mettinoktay/Final_Thesis/README.md

# Final_Thesis

Is anyone reading this? Okay.

Here is the bachelor thesis work of mine at Yıldız Technical University in İstanbul. I'm building a small scale wind turbine.
