mettinoktay/Final_Thesis/Final Report/#3 Teşekkür.docx

Teşekkür

Tezim süresince yardımlarını esirgemeyen danışmanım Yrd. Doç. Dr. Hatice Mercan’a,

parçaları üretmemde cömertçe yardımda bulunan PrintekLabs’ın kurucuları Samet ve Onur’a,

ve özellikle aileme

ne kadar teşekkür etsem az kalır.
