mettinoktay/Final_Thesis/Final Report/#1 Kapak.docx

YILDIZ TEKNİK ÜNİVERSİTESİ

MAKİNE MÜHENDİSLİĞİ FAKÜLTESİ

YATAY EKSEN RÜZGAR TÜRBİNİ

ÜRETİMİ ve TEST EDİLMESİ

Metin Oktay Yılmaz

11067027

MEKATRONİK MÜHENDİSLİĞİ ANABİLİM DALI’NDA HAZIRLANAN

BİTİRME TEZİ

Tez Danışmanı: Yrd. Doç. Dr. Hatice Mercan

İstanbul, 2016
