mettinoktay/Final_Thesis/Design Report - Turkish/MST Raporu - 2015 Güz - Metin Oktay Yılmaz - 11067027.pdf

### YILDIZ TEKNİK ÜNİVERSİTESİ MAKİNE MÜHENDİSLİĞİ FAKÜLTESİ

## YATAY EKSEN RÜZGAR TÜRBİNİ TASARIMI ve KONTROLÜ

### Metin Oktay Yılmaz

11067027

MEKATRONİK MÜHENDİSLİĞİ ANABİLİM DALI’NDA HAZIRLANAN

## MEKATRONİK SİSTEM TASARIMI RAPORU

### Proje Danışmanı: Yrd. Doç. Dr. Hatice Mercan

İstanbul, 2015

### YILDIZ TEKNİK ÜNİVERSİTESİ

### MAKİNE MÜHENDİSLİĞİ FAKÜLTESİ

## YATAY EKSEN RÜZGAR TÜRBİNİ

## TASARIMI ve KONTROLÜ

### Metin Oktay Yılmaz

11067027

MEKATRONİK MÜHENDİSLİĞİ ANABİLİM DALI’NDA HAZIRLANAN

## MEKATRONİK SİSTEM TASARIMI RAPORU

### Proje Danışmanı: Yrd. Doç. Dr. Hatice Mercan

İstanbul, 2015

İçindekiler

### 5.5 Dönel Akışın İhmal Edildiği Şartlarda İdeal Kanat Geometrisi ve Kanat Elemanı

REVİZYON TARİHÇESİ

Tarih | Rev. Numarası | Tanım | Yazar(lar)
25.12.2015 | 1.0 | Başlangıç Dokümanı | Metin Oktay Yılmaz

SİMGE LİSTESİ

c: Kanat veter uzunluğu, sönümleme katsayısı

m: Kütle

k: Yay sabiti

r: Rotor merkezine olan uzaklık, yarıçap

dr: Elemanın uzunluğu

R: Rotor yarıçapı

m: Kütle

k: Yay sabiti

V, U: Hız

P: Güç

F: Kuvvet

Q: Tork

a1..n : Regresyon katsayıları

a: İndüksiyon faktörü

k: Şekil parametresi

c: Ölçek parametresi

Cp: Kapasite faktörü

Ke: Enerji patern faktörü

CL: Taşıma katsayısı

CD: Sürükleme katsayısı

B: Kanat sayısı

P, I, D: PID denetleyici katsayıları

L: Laplace dönüşümü

YUNAN HARFLERİ

Ω: Rotor açısal hızı

α: Hücum açısı

ρ: Yoğunluk

Ω: Rotor açısal hızı

φ: Bağıl rüzgar hızı açısı

λ: Uç hız oranı

σ: Standart sapma

θx: Kanat ile ilişkili açılar

Δ: Diskriminant

KISALTMALAR
TÜREB Türkiye Rüzgar Enerjisi Birliği

GWEC Global Wind Energy Council

IEA International Energy Association

EWEA European Wind Energy Association

ŞEKİL LİSTESİ

ŞEKIL 1: KITALARA GÖRE YILLIK TÜRBIN KURULUM MIKTARI [10] | 8
ŞEKIL 2: TÜRKIYE’DE YILLARA GÖRE TÜRBIN KURULUMU [1]. İZINSIZ KULLANILMIŞTIR | 9
ŞEKIL 3: YATAY EKSEN VE DIKEY EKSEN RÜZGAR TÜRBINI | 9
ŞEKIL 4: VESTAS V47-660 KW TÜRBININE AIT GÜÇ EĞRISI | 11
ŞEKIL 5: YILLIK RÜZGAR HIZI DATASI VE WEIBULL DAĞILIMI | 14
ŞEKIL 6: RÜZGAR TÜRBINI EYLEYICI DISK MODELI | 14
ŞEKIL 7: BETZ TÜRBINI IÇIN ÇALIŞMA PARAMETRELERI | 18
ŞEKIL 8: DÖNEL AKIŞLI EYLEYICI DISK MODELI | 18
ŞEKIL 9: ROTOR ANALIZINDE KULLANACAĞIMIZ GEOMETRI | 18
ŞEKIL 10: NACA5518 PROFILI VE XFOİL’DE ÇIKARILMIŞ CL/CD GRAFIĞI | 22
ŞEKIL 11: KANAT ELEMAN TEORISINDE KULLANILACAK KANAT MODELI | 24
ŞEKIL 12: ANALIZDE KULLANILACAK KANAT GEOMETRISI VE NOTASYONLAR | 24
ŞEKIL 13: VETER UZUNLUĞU VE BURULMA AÇISI KANAT BOYU DAĞILIMLARI | 28
ŞEKIL 14: YARIÇAPI 1 METRE OLAN TÜRBININ VETER UZUNLUĞU DAĞILIMI | 29
ŞEKIL 15: DÖNEL AKIŞLI TÜRBININ VETER VE BURULMA DAĞILIMI | 30
ŞEKIL 16: t = 0’DAN SONRA SİSTEME UYGULANMIŞ BASAMAK FONKSIYONU | 31
ŞEKIL 17: DÜŞÜK SÖNÜMLÜ SISTEMIN BASAMAK CEVABI | 32
ŞEKIL 18: KARARLI SÖNÜMLÜ SISTEMIN BASAMAK CEVABI | 32
ŞEKIL 19: AŞIRI SÖNÜMLÜ SISTEMIN BASAMAK CEVABI | 33
ŞEKIL 20: DÜŞÜK SÖNÜMLÜ SISTEMIN FARKLI P KATSAYILARINA TEPKISI | 33
ŞEKIL 21: P KATSAYISININ KARARLI SÖNÜMLÜ SISTEM ÜZERINE ETKISI | 34
ŞEKIL 22: P KATSAYISININ AŞIRI SÖNÜMLÜ SISTEM ÜZERINE ETKISI | 34
ŞEKIL 23: I KATSAYISININ DÜŞÜK SÖNÜMLÜ SISTEM ÜZERINE ETKISI | 34
ŞEKIL 24: I KATSAYISININ KARARLI SÖNÜMLÜ SISTEM ÜZERINE ETKISI | 35
ŞEKIL 25: I KATSAYISININ AŞIRI SÖNÜMLÜ SISTEM ÜZERINE ETKISI | 35
ŞEKIL 26: D KATSAYISININ DÜŞÜK SÖNÜMLÜ SISTEM ÜZERINE ETKISI | 35
ŞEKIL 27: D KATSAYISININ KARARLI SÖNÜMLÜ SISTEM ÜZERINE ETKISI | 36
ŞEKIL 28: D KATSAYISININ AŞIRI SÖNÜMLÜ SISTEM ÜZERINE ETKISI | 36
ŞEKIL 29: VETER UZUNLUĞU DAĞILIMI GRAFIĞI | 37
ŞEKIL 30: BURULMA AÇISI DAĞILIMI GRAFIĞI | 37
ŞEKIL 31: ELDE EDILEN VERILERLE OLUŞTULAN ROTOR | 37
ŞEKIL 32: QBLADE'IN OPTIMIZAYONU SONUCU ELDE EDILEN ROTOR | 37
ŞEKIL 33: SEEEDUINO ARCH PRO | 38
ŞEKIL 34: SISTEMIN KABA BLOK DIYAGRAMI | 39
ŞEKIL 35: KART ŞEMATIĞI | 41
ŞEKIL 36: PROJE TAKVIMI | 44

TABLO LİSTESİ

TABLO 1: λ VE a2 FONKSIYONU OLARAK Cp, max | 22

FOTOĞRAF LİSTESİ

FOTOĞRAF 1: KAFEE MUEHLE, BREMEN, ALMANYA [5] | 7

ÖZET

Bu çalışmada, yatay eksen rüzgar türbinleri incelenmiş ve 50W güç üretecek bir türbin

tasarlanmıştır. Fosil yakıtların zararlarının iyice görülmeye başlandığı bu yıllarda, yenilenebilir

enerji kaynaklarına olan rağbet artmıştır. Her geçen yıl daha fazla yatırım almakta olan rüzgar

enerjisi ülkemizde de aynı ilgiyi görmektedir.

İlk üç bölümde teorik bilgi verilmiş, son bölümde tasarım anlatılmıştır. Türbin kanatları, türbin

kontrol kartı ve kontrol algoritması tasarlanmıştır. Türbin tasarımı ve ilişkili analizler QBlade

ve MATLAB kullanılarak yapılmıştır. Proje dosyaları (ilerleyen zamanlarda kontrol yazılımı

da dahil) github.com/mettinoktay adresinden indirilebilir.

Anahtar kelimeler: rüzgar türbini, PID kontrol, türbin kontrolü, türbin tasarımı

### 1. GİRİŞ

### 1.1 Amaç

Bu projede amaç, 50 watt güç üretecek, 1 metre yarıçaplı bir türbin tasarlamak; elektronik devre

tasarımlarını yapmak ve kontrol algoritması geliştirmektir.

### 1.2 Motivasyon

Rüzgar türbini yatırımları her sene artmaktadır [1]. Ancak ülkemizde rüzgar türbinleri üzerine

Ar-Ge çalışmaları yürütülmemektedir. Bu naçizane çalışmanın, kendi hedeflerim için bir

başlangıç noktası olmasını hedeflemekteyim.

### 1.3 Kapsam

Bu proje, Yıldız Teknik Üniversitesi Mekatronik Mühendisliği bölümünde yapılmıştır.

Dolayısıyla tüm elektronik, mekanik ve yazılım işleri proje dahilindedir, ancak üretilmesi

planlanan türbinin boyutları derin analiz gerektirmemektedir. Bu sebeple matematiksel teori

basitleştirilmiştir.

### 1.4 Literatür Taraması

Çalışmanın teorik kısmı Wind Energy Explained Theory, Design and Application (ISBN 0

471 49972 2) kitabından ve [2] ve [3] makalelerinden alınmıştır. Türbin karakteristik eğrileri

veya değerleri literatürdeki makalelerden alınmıştır. Hava kirliliği konusundaki haberler

tr.euronews.com sitesinden alınmıştır. Rüzgar türbin yatırım trendleri ve son durumu hakkında

araştırma ulusal ve uluslararası kuruluşların raporlarından alınmıştır.

### 1.5 Kabuller ve Varsayımlar

Teorik ve Pratik kısımlarda yapılmış varsayımlar bölümlerde verilmiştir.

### 2. GEREKSİNİM SPESİFİKASYONLARI

### 2.1 Pazar Gereksinimleri

1. Verim %30’un üzerinde olmalıdır.
2. Dışarıdan bakıldığında estetik bir görüntü vermelidir.

Pazar Gereksinimleri | Teknik Gereksinimler | Açıklama
1 | Kanat tasarımı, ideal tasarıma yakın olmalıdır. | [4] incelenerek kararlaştırılmıştır.
2 | En az üç kanatlı bir rotor tasarlanmalıdır. | Kaynaklar incelenerek kararlaştırılmıştır.

### 3. RÜZGAR ENERJİSİ ve RÜZGAR TÜRBİNLERİ

Antik çağlardan bu yana enerjisinden faydalanılan rüzgar, genellikle değirmenlerde mısır ve

buğday öğütmek veya evlere su pompalamak için kullanımıştır. Günümüzde yerlerini elektrik

enerjisiyle çalışan tiplerine bırakan bu değirmenler, kimi yerlerde turistleri cezbetmek amacıyla

kullanılmaktadır.


Fotoğraf 1: Kafee Muehle, Bremen, Almanya [5]

Rüzgardan elektrik üretmenin llk denemeleri 1888 yılında Charles Brush tarafından Cleveland,

Ohio’da yapılmıştır [6]. Ardından geliştirme çalışmaları devam etmiş ancak 1900’lerin başında

fosil yakıtla çalışan enerji üreteçlerinin ortaya çıkması rüzgar enerjisini arka plana atmıştır. O

günden beri fosil yakıtlarla çalışan motorlar ve jeneratörler ilk tercih olmuştur ancak fosil

yakıtın zararlı getirileri, günümüzde etkisini hissettirmektedir. Dünya genelinde kimi şehirlerde

hava kirliliği tarihin en yüksek değerlerine ulaşmış, belediyeler önlemler almaya başlamışlardır

[7] [8]. Bu gibi sebepler, toplumu ve yöneticileri yenilenebilir enerji kaynaklarına

yaklaştırmıştır. Bu kaynaklar arasında en çok rağbet görenler güneş enerjisi, jeotermal enerji,

hidroelektrik enerji ve rüzgar enerjisidir.

### 3.1 Dünyada Rüzgar Enerjisi

Dünyada rüzgar enerjisinin gelişiminde öncü ülkeler Almanya, İspanya, Danimarka ve ABD

olmuştur. Danimarka, 2014 yılında enerji ihtiyacının %39.1’ini rüzgardan karşılamıştır [9].

Avrupa Birliği üye ülkeleri, 2030 yılında enerjisini %19’u ila %31’i arasında oranla rüzgardan

karşılamayı planlamaktadır.


Şekil 1: Kıtalara göre yıllık türbin kurulum miktarı [10]

### 3.2 Türkiye’de Durum

Türkiye, 2000 yılından bu yana her yıl artan oranda rüzgar enerjisine yatırım yapmaktadır

(Grafik 2). Türkiye Rüzgar Enerjisi Birliği’nin Ocak 2015 tarihli raporuna göre kurulumu

devam eden türbinlerin toplam gücü 1210 MW’tır [1]. Türkiye 2023 yılına kadar kurulu gücünü

9418 MW’a çıkarmayı planlamaktadır [11].

### 3.3 Modern Rüzgar Türbinleri

Rüzgar türbinleri, rotorlarının dönüş eksenine göre ikiye ayrılır: dikey eksen rüzgar türbinleri

ve yatay eksen rüzgar türbinleri. Dikey eksen rüzgar türbinleri, kurulumu ve işletimi kolay

ancak bakımı zor, verimi düşük makinelerdir. Yatay eksen rüzgar türbinleri ise kurulumu zor,

verimi yüksek ve bakımı kolay makinelerdir. Uzun vadede getirisi dikey eksen türbinlere oranla

daha yüksektir.

### 3.4 Yatay Eksen Rüzgar Türbini

Dikey eksen türbinlerden üstünlüklerini kanıtlayan yatay eksen türbinler üretici şirketlerin

tercihi olmuştur. Birkaç kişisel kullanım için kurulu dikey eksen türbinlerin dışında kurulu

türbinlerin tamamı yatay eksen türbinlerdir.


Şekil 2: Türkiye’de yıllara göre türbin kurulumu [1]. İzinsiz kullanılmıştır.


Şekil 3: Yatay eksen ve dikey eksen rüzgar türbini

Türbin Bileşenleri

Rotor

Rüzgarın mekanik enerjisini yakalayan parçadır. Kanat ve kanat merkezinden oluşur. Tek

kanatlı, iki kanatlı ve üç kanatlı olabilir. Küçük türbinlerde (10 kW ve altı) dört veya beş kanatlı

modeler görülebilir. Küçük türbinlerde sabit pitch açılı kanatlar kullanılırken büyük türbinlerde

aktif kontrollü tasarımlar tercih edilmektedir. Kanat geometrisinde dikkat edilmesi gereken

hususlar 3. bölümde anlatılacaktır.

Aktarma Organı

Rotor, yakaladığı enerjiyi aktarma organlarıyla jeneratöre aktarır. Aktarma organı genellikle

redüktör dişli sisteminden oluşur. Rotor jeneratörün elektrik üretemeyeceği açısal hızlarda dönmektedir. Bu sebeple rotor ile jeneratör bir redüktör dişli sistemi ile bağlanır ve rotor devri

yükseltgenerek jeneratöre aktarılır.

Jeneratör

Elektriğin üretildiği kısımdır. Jeneratörler alternative akım kaynağıdır. Çoğunlukla indüksiyon

jeneratörü veya senkron jeneratörler kullanılır. Şebeke frekansından farklı frekanslarda üretilen

AC gerilim, 60 Hz frekansa çekildikten sonra şebekeye aktarılır.

Beşik ve Yaw Sistemi

Beşik jeneratör, yaw sistemi, aktarma organı ve kontrolör için saklama kabı görevi görür.

Ayrıca üst aksamın yaw sistemi ile kuleye bağlanmasını da sağlar.

Yaw sistemi, rotorun, kule ekseni etrafında dönmesini ve rotorun rüzgarı karşıdan almasını

sağlar. Küçük türbinlerde, türbin arkasındanki yatay stabilizörler bu işi görürken, büyük

türbinlerde kütleden ötürü aktif kontrol gerekmektedir.

Kule ve Zemin

Türbin en nihayetinde kuleye oturtulur. Rüzgar hızı irtifa ile doğru orantılıdır. Kule uzunluğu,

bu ilişki göz önünde bulundurulara seçilir. Kule uzunluğu, coğrafi şartlara göre belirlenecek

minimum uzunluktan kısa kalmamak şartıyla en az rotor çapının 1-1.5 katı uzunluğunda

olmalıdır.

Kontrol Sistemi

Türbin verimi ve işletim kolaylığı açısından kontrol sistemi önemli role sahiptir. Rüzgar

şartlarına göre türbini manipüle edip aşırı yüklemeyi önlemek ve rüzgardan maksimum enerjiyi

çıkarmaya çalışmak kontrol sisteminin görevidir. Kontrol sistemi aşağıdaki elemanlardan

oluşur:

- Sensörler (sıcaklık, rüzgar hızı, rüzgar yönü ve sair)
- Eyleyiciler (yaw ve pitch motorları)
- Güç yükselteçleri (sürücü devreler)
- Denetleyici

### 3.5 Türbin Güç Eğrisi

Türbin güç eğrileri, türbinden farklı rüzgar hızlarında ne kadar güç alınabileceğini gösterirler.

Türbin eğrileri aşağıdaki parçalı fonksiyon kullanılarak hesaplanır:

f(x) = {

0 | , V < VI
(a1V

3 + a2V

| 2 + a3V + a4)PR , VI ≤ V < VR
PR | , VR ≤ V < VO
0 | , V ≥ VO

(0.1)

a1−4, türbin güç eğrisi regresyon katsayıları, PR, türbinin verebileceği maksimum enerji, V ise

rüzgar hızıdır. VI

türbinin dönmeye başladığı hız, VO ise türbinin yapısal olarak çalışmaya

dayanabileceği maksimum rüzgar hızıdır. Türbin VR − VO arasında maksimum verimle çalıştığı

hız aralığıdır.

Vestas V47-660kW türbini için regresyon katsayıları, VI

, VO, VR , PR [12] ve güç eğrisi

aşağıdaki gibidir:

a1 = −0.00169, | a2 = 0.04446, | a3 = −0.24764, | a4 = 0.39209
PR = 660kW, | VI = 4
| m s
| , | VO = 25m s
| | , | VR = 15 m s


Şekil 4: Vestas v47-660 kW türbinine ait güç eğrisi

### 4. RÜZGAR ANALİZİ

Her rüzgar estiği düşünülen alan, türbin kurulumu için uygun değildir. Sürekli enerji elde

etmeye elverişli olduğu düşünülen bir alanda, uzun zaman boyunca ölçüm yapılır. Elde edilen

veriler, çeşitli yöntemlerle anlamlandırılır. Türbin verileri ve alan verileri bir arada

kullanıldığında bir alandan elde edilebilecek enerji miktarı kestirilebilir. Sonuç olarak, alanın

ekonomik değerinin olup olmadığı kararlaştırılmış olur.

Rüzgar hızı ölçerken, her saniye rüzgar hızını ölçmek etkili bir yöntem olarak görülmemektedir.

IEA’nın tavsiyesi, rüzgar hızını 10 dakikada bir ölçmek ve ölçülen her gün için ayrı ayrı rüzgar

hızı ortalamalarını almaktır [12].

Türkiye, rüzgardan enerji elde etme potansiyeli yüksek bir ülkedir. Enerji potansiyeli en yüksek

bölge, 50 metre irtifada yıllık 6.9 m/s rüzgar hızıyla Marmara ve Ege kıyılarıdır [11]. Gökçek ve arkadaşlarının Kırklareli’de yaptığı çalışma sonucu [3], güç yoğunluğunu 138.85 W/m²

olarak belirlemiş ve makul bir değer olduğuna karar vermiştir.

Çembersel A alanından, U hızıyla geçmekte olan, ρ yoğunluklu hava kütlesinin sahip olduğu

güç aşağıdaki ifade ile verilir:

P =

1
2

ρAU

3
(watt) | (0.1)

Güç yoğunluğu P
A

ise aşağıdaki ifadedir:

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
watt
m²
) | (0.2)

A çembersel alanının rotor alanı olduğu düşünüldüğünde rüzgarın rotora taşıdığı güç, rüzgar

güç yoğunluğunun rotor alanıyla çarpılmasıyla bulunabilir.

Rüzgarın, yıllık ortalama güç yoğunluğu ise şu ifadeyle verilir:

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
(0.3)

U, ortalama rüzgar hızı, Ke ise enerji patern faktörüdür.

U =

1
N

∑ Un

N
n=1

(0.4)

Ke =

1

NU

3 ∑ Ui

N
i=1

3
(0.5)

Hava yoğunluğu, sıcaklık ve irtifa ile ters orantılıdır. Hız ölçümleri sabit irtifada yapıldığı için

irtifa etkisi göz ardı edilebilir ancak mevsimsel sıcaklık farklılıkları, hava yopunluğunun

değişmesine, dolayısıyla rüzgarın taşıdığı gücün değişmesine neden olur.

ρ =
N

∑ ρi

N
n=1

(0.6)

### 4.1 Rüzgar Verisinin İstatistiksel Yöntemlerle İncelenmesi

Rüzgar hızı verisi, türbin verisiyle birlikte kullanıldığında türbinden elde edilecek enerji hatalı

da olsa tahmin edilebilir. Rüzgar hızı incelenirken en çok kullanılan iki yöntem Rayleigh

dağılım fonksiyonu ve Weibull dağılım fonksiyonudur. Gerçek zamanlı verilere uygunluk

açısından Weibull dağılım fonksiyonu daha iyi sonuç vermektedir [12] [3] [13].

Weibull Dağılım Fonksiyonu

Dağılım fonksiyonları, bir veri aralığında, verilerin görülme frekansını veren fonksiyonlardır.

Rüzgar datası göz önüne alındığında, bir alanda, bir yıl boyunca rüzgarın en çok hangi hız

aralığında estiği görülebilir. Wiebull dağılım fonksiyonu aşağıdaki ifade ile verilir:

fw(v) =

k
c

(

v
c

)

k−1
exp [− (
v
c

)

k
] | (0.7)

1.8 denklemindeki k şekil parametresi ve c ölçek parametresidir. Weibull dağılımının

toplamsal dağılım fonksiyonu ise aşağıdaki ifade ile verilir:

Fw(v) = 1 − exp [− (
v
c

)

k
] | (0.8)

k ve c parametrelerini hesaplamak için aşağıdaki ifadeler kullanılabilir:

k = (

σ
v

)

−1.0086
(1 ≤ k ≤ 10) | (0.9)

c = U (0.568 +

0.433
k

)

−

1
k | (0.10)

σ, rüzgar verisinin standart sapma değeridir ve aşağıdaki ifade ile hesaplanır:

σ = [

1
n−1

∑ (Vi − V)

2 n
| i=1

]

0.5
(0.11)

Aşağıdaki grafiklerde, MATLAB® ortamında raylrnd fonksiyonu kullanılarak üretilmiş rasgele

rüzgar verisi, Weibull dağılımı ve enerji hesaplamaları görülebilir. .m dosyaları, projenin Github sayfasından indirilebilir. Örnek türbin, Vestas v47-660 kW türbinidir.


Şekil 5: Yıllık rüzgar hızı datası ve Weibull dağılımı.

### 5. RÜZGAR TÜRBİN AERODİNAMİĞİ

Rüzgardan enerji elde etmek, rüzgar ile türbin arasındaki etkileşime dayanır. Kanatlarda

kullanılacak profil, rüzgar hızının kanat uç hızına oranı, kanadın burulma açısı gibi etmenler

verim üzerinde büyük rol oynar. Bu bölümde türbin aerodinamiği ile tasarım parametrelerinin

hesaplanması verilmiştir.

### 5.1 Tek Boyutlu Momentum Teorisi ve Betz Limiti [14]

Tek boyutlu momentum teorisi, momentum korunumu ilkesine dayanarak rüzgardan elde

edilebilecek maksimum verim değerini ortaya koyar. Aşağıdaki şekilde akış ve türbin modeli

görülmektedir.


Şekil 6: Rüzgar türbini eyleyici disk modeli

Rüzgarın diske uyguladığı itki kuvveti, tek yönlü, sıkıştırılamaz ve zamandan bağımsız akışın

momentum değişimine eşittir:

T = U1

(ρAU)1 − U4

(ρAU)4 | (3.1)

Kütlenin korunumu ilkesinden:

(ρAU)1 = (ρAU)4 = ṁ | (3.2)

Bu sebeple:

T = ṁ (U1 − U4) | (3.3)

Eyleyici diskin solunda ya da sağında iş yapılmadığından Bernoulli denklemleri geçerlidir:

P1 +

1
2

ρU1

2 = P2 +

1
2

ρU2

2
(3.4)

P3 +

1
2

ρU3

2 = P4 +

1
2

ρU4

2
(3.5)

3.3 ve 3.4’te şu varsayımlar yapılmıştır:

P1 = P4 U2 = U3

İtki kuvveti, eyleyici kuvvetin iki yanındaki basışçların farki cinsinden de yazılabilir:

T = A1(P2 − P3) | (3.6)

3.4 ve 3.5 kullanılarak P2 − P3 yazılırsa:

T =

1
2

ρA2(U1

2 − U4

2
) | (3.7)

3.4 ve 3.5 birbirine eşitlenir ve ṁ = A2U2 olarak yazılırsa,

U2 =

U1+U4
2

(3.8)

rotordaki rüzgar hızı, yukarı yönden gelen akım ile aşağı yöne giden akımın hızının aritmetik

ortalaması olduğu görülür.

Eksenel indüksiyon faktörü a, akış hızlarının oransal azalımı olarak tanımlanır:

a =

U1−U2
2

(3.9)

U1 ve U2 hızları yeniden yazılırsa:

U2 = U1

(1 − a) | (3.10)
U4 = U1(1 − 2a) | (3.11)

3.10’daki U1a terimi, rotorda indüklenmiş hızdır ve rüzgarın serbest akış hızı ile indüklenmiş

rüzgar hızının kombinasyonudur. a,[0, 1] arası tanımlıdır ve değeri 1’e yaklaştıkça, aşağı

yöndeki akış hızı sıfıra yaklaşır. a = 0.5 iken U4 = 0 olur; bu türbinin arkasında akış olmadığı

anlamına gelir ve teori geçersiz kalır.

Rüzgardan elde edilecen güç, rotordaki rüzgar hızı ve itki kuvvetinin çarpımına eşittir:

P =

1
2

ρA1

(U1

2 − U4

2
)V2 =

1
2
ρA2U2(U1 − U4)(U1 + U4) | (3.12)

3.10 ve 3.11, 3.12’de yerlerine konulursa:

P =

1
2

ρAU

34a(1 − a) | (3.13)

Rüzgar türbini performansı, güç katsayısı Cp ile temsil edilir:

Cp =

P
0.5ρAU³ | (3.14)
(3.13) kullanılarak bir önceki denklem tekrar yazılır:

Cp = 4a(1 − a)

2
(3.15)

Cp’nin en yüksk değerini bulmak için a’ya göre türevi alınınp sıfıra eşitlenirse a =

1
3

olduğu

görülür. Bu durumda,

Cp = 0.5926 | (3.16)

olduğu görülür. Betz limiti olarak bilinen bu değer rüzgar türbinlerinin erişebileceği maksimum verim değeridir. U2’nin 2
3

U1 değerine eşit olması durumunda teorik olarak en yüksek verim

elde edilir. Pratikte üç etki verimi düşürür:

- Türbin arkasında meydana gelen dönel akış(wake rotation)
- Rotor sayısının sonlu oluşu ve kanat uçlarındaki kayıplar
- Aerodinamik sürükleme kuvveti

Rotordaki itki kuvveti aşağıdaki ifade ile verilir:

T = 0.5ρAU1

2
[4a(1 − a)] | (3.17)

Güç katsayısına benzer bir töntemle, turbine etki eden itki birimsiz bir katsayıyla gösterilebilir:

CT =

T
0.5ρU²A

=

itki kuvveti
dinamik kuvvet

(3.18)

(3.17), (3.18)’de yerine yazılırsa:

CT = 4a(1 − a) | (3.19)

a = 0.5 olduğunda CT = 1 olur. Maksimum verim şartlarında CT =

8
9

değerine sahiptir.

### 5.2 Dönel Akışlı İdeal Yatay Eksen Rüzgar Türbini [15]

Önceki bölümde, rotor arkasındaki dönel akış ihmal edilerek analiz yapıldı. Bu analiz,

dönmekte olan rotorun açısal momentum oluşturduğu duruma genişletilebilir.Pratikte, rotor

arkasındaki akış, rotora uygulamış olduğu kuvvet sonucu rotorun tersi yönde döner. Aşağıdaki

şekil, bu durumu modellemektedir.


Şekil 7: Betz türbini için çalışma parametreleri


Şekil 8: Dönel akışlı eyleyici disk modeli

Akışın dönel hareketi, verimi düşürücü etki yapar. Dönel akışın kinetik enerjisi, turbine etkiyen

tork ile doğru orantılıdır. Dolayısıyla yüksek hızda dönüp kanatlarına düşük tork uygulanan

türbinler, düşük hızda dönüp yüksek tork üreten türbinlerden daha verimlidirler.


Şekil 9: Rotor analizinde kullanacağımız geometri

Kontrol hacminin rotorun dönüş hızıyla aynı açısal hıza sahip olduğu varsayılırsa, enerji

denklemleri 2 ve 3 arasındaki basınç farkını türetmek için kullanılabilir (Glaubert, 1935). Sonuç

olarak şu denklem elde edilir:

P2 − P3 = ρ(Ω + 0.5ω)ωr

2
(3.20)

Ortaya çıkan çembersel kuvvet elemanı dT:

dT = (P2 − P3

)dA = [ρ(Ω + 0.5ω)ωr

2
]2πrdr | (3.21)

Açısal indüksiyon faktörü, a′, şu şekilde tanımlanır:

a

′ =

ω
2Ω

(3.22)

Dönel akış hesaba katıldığı zaman, rotorda indüklenmiş hız sadece eksenel bileşen Ua’dan

değil, rotor yüzeyindeki bileşen rΩa’dan da oluşur. O halde itki ifadesi şöyle olur:

dT = 4a

′
(1 + a

′
)0.5ρΩ

2
r
22πrdr | (3.23)

Bir önceki bölümde, doğrusal momentum korunumu analizinde, çembersel kesit alanındaki itki

kuvveti, eksenel indüklenme faktörü a’yı kullanan bir ifade ile yazılabilir:

a(1−a)
a′(1+a)

=

Ω²r

2
U² = λr

2
(3.24)

λr
ifadesi, bölgesel hız oranı olarak tanımlanır. Bu oran, kanadın bir noktasının çizgisel hızının

rüzgarın hızına oranı olarak tanımlanır. λ uç hız oranı ise kanat ucunun çizgisel hızı ile rüzgar

hızının oranıdır ver türbin verimiyle doğrudan ilişkilidir.

λ =

ΩR
r

(3.25)

λr =

λr
R

(3.26)

Açısal momentum korunumu ilkesi kullanılarak rotor torku için bir ifade türetilebilir. Bu

durumda, rotora uygulanan tork Q , dönel akışın açısal momentum değimine eşit olur.

Çembersel elemanlar üzerinde bu ifade,

dQ = dm(ωr)(r) = (ρU22πrdr)(ωr)(r) | (3.27)

U2 = U(1 − a) ve a

′ =

ω
2Ω

olduğundan dQ aşağıdaki şekilde ifade edilebilir:

dQ = 4a

′
(1 − a)0.5ρUΩr
22πrdr | (3.28)

Her elemanda üretilen güç dP aşağıdaki ifadeye eşit olur:

dP = ΩdQ | (3.29)

dQ yerine 3.27 yazılıp, bölgesel hız oranı λr kullanılırsa her elemanda üretilen güç ifadesi şu

şekli alır:

dP = 0.5ρAU

3

[

8
λ

2

a

′
(1 − a)λr

3dλr

] | (3.30)

Elde edilecek gücün, eksenel ve açısal indüksiyon faktörlerinin ve uç hız oranının bir

fonksiyonu olduğu görülür. Eksenel ve açısal indüksiyon faktörleri rotor düzlemindeki akışın

yönünü ve büyüklüğünü belirler.

Her bir çembersel parçanın, güç katsayısına yaptığı katkı dCp şu ifadeyle verilir:

dCp =

dP
0.5ρAU³

(3.31)

Dolayısıyla Cp şöyle ifade edilebilir:

Cp =

8
λ

2 ∫ a

′
(1 − a)λr

3dλr

λ
0

(3.32)

Bu integralin çözülebilmesi için a

′ ve a ifadelerinin λr
şeklinde yazılması gerekir. (3.23)

denklemi a′’nü a cinsinden yazacak şekilde yeniden yazılacak olursa:

a

′ =

1
2

+

1
2

√[1 +
4
λr
2 a(1 − a)] | (3.33)

Maksimum güç elde edilmesi için gerekli aerodinamik koşullar 3.31 denklemindeki a

′
(1 − a)

ifadesi en yüksek değerini aldığında oluşur. 3.32, a

′
(1 − a) ifadesinde yerine yazılıp, ifadenin

türevi sıfıra eşitlenirse aşağıdaki ifade elde edilir:

λr

2 =

(1−a)(4a−1)
1−3a

(3.34)

Bu ifade, her bir elemandan maksimum gücü ede edebilmek için gerekli indüksiyon faktörünü,

bölgesel hızın bir fonksiyonu olarak tanımlar; 3.23’de yerine yazıldığında her bir halkada

maksimum güç için gerekli şart ifadesi elde edilir:

a

′ =

1−3a
4a−1

(3.35)

3.33 ifadesi a’ya göre türevlendiğinde maksimum güç koşullarında dλr ve da arasındaki ilişki

elde edilir:

2λrdλr = [

6(4a−1)(1−2a)

2
(1−3a)²
] da | (3.36)

3.34-36, 3.33’de yerine yazılırsa, Cp için bir ifade elde edilir:

Cp,max =

24
λ

2 ∫ [

(1−a)(1−2a)(1−4a)
1−3a

]

2
da a2
a1

(3.37)

İntegral sınırları a1 , λr = 0 olduğundaki eksenel indüksiyon faktörüne; a2 ise λr = λ

olduğundaki eksenel indüksiyon faktörüne eşittir. Ayrıca 3.34’ten şu ifade elde edilebilir:

λ

2 =

(1−a2

)(1−4a2

)

2

1−3a2

(3.38)

3.37 ifadesinde (1 − 3a) = x yazılarak integral çözülebilir (Eggleston ve Stoddard, 1987):

Cp,max =

8
729λ

2

[

64
5

x

5 + 72x

4 + 124x

3 + 38x

2 − 63x − 12lnx −

4
x
] | (3.39)

Aşağıdaki tablo ve grafik, farklı λ değerleri için Cp ve a2 değerlerini vermektedir. Sonuçlar

incelendiğinde, uç hız oranı yükseldikçe güç katsayısının da arttığı görülür.

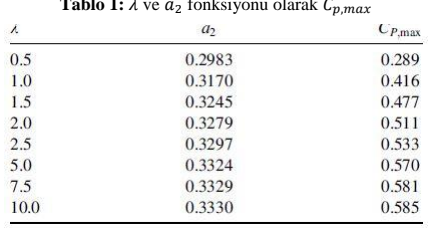
[picture p82: figure]

### 5.3 Kanat Profilleri ve Genel Aerodinamik [2]

Sürükleme kuvvetinden faydalanan türbinlerin aksine modern türbinler, uçaklar gibi taşıma

kuvvetinden faydalanır. Kanat tasarımları, uygulamalarındaki farklılıklarından ötürü geometrik

olarak farklılık gösterse de aynı amaca hizmet eder: taşıma kuvveti oluşturmak.

Türbin kanadı tasarımında kullanılacak kanat profili, yüksek CL/CD oranına sahip profillerden

seçilir. Genellikle CL/CD > 30 olan profiller, türbinde kullanılmak için uygun kabul edilir.

Yapısal gereklilikler ve verim göz önüne alındığında kanat boyunca aynı profili kullanmak,

istenen sonucu vermez. Kanadın muakvim bir yapıya sahip olması için, kanat köküne doğru

kullanılan profili yüksek kalınlık/veter oranına sahip olması gerekir.

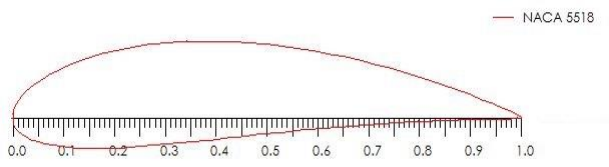
[picture p83: figure]

Şekil 10: NACA5518 profili ve XFOİL’de çıkarılmış CL/CD grafiği.

CL/CD oranı üzerinde yalnızca kanat profili etkili değildir. Şekil 5’te verilen grafikte, bu oranın

hücum açısı α’ya göre değişimi verilmiştir. Hücum açısı, kanat veteri ile görece rüzgar hız

vektörünün yaptığı açıya denir.Hücum açısını doğru kontrol etmek gerekir, zira α’nın aşırı

değerlerinde stall denilen hadise meydana gelebilir. Stall, taşıma kuvvetinin hızla düştüğü

sütüklenme kuvvetinin hızla arttığı bir olaydır. Havacılıkta istenmeyen bir durumdur ve

Tablo 1: λ ve a2 fonksiyonu olarak Cp,max akroatik uçuşlar dışında çoğunlukla kaçınılır ancak rüzgar türbinlerinde, rüzgarın aşırı

hızlandığı durumlarda, aşırı yüklenmeyi önlemek adına rotor hızını düşürmek için

faydalanılabilir.

Kanat boyunca açısal hız sabit bir değerdedir, ancak çizgisel hız, merkezden uzaklıkla doğru

orantılı olarak artar (v = ωr). Artan çizgisel hız, rüzgarın kanat boyunca farklı hücum açılarıyla

rüzgarı karşılaması demektir. Bu sebeple, kanat, kökten uca doğru burularak gelir. Burulma,

kanat profilinin en yüksek CL/CD oranını verdiği hücum açısı göz önünde bulundurularak

hesaplanır.

### 5.4 Momentum Teorisi ve Kanat Eleman Teorisi [16]

Momentum Teorisi, kontrol hacminin kanat üzerine uyguladığı kuvvetlerin doğrusal ve açısal

momentum korunumu ilkelerine dayalı analizine dayanır. Kanat Eleman Teorisi, kanat

üzerindeki bir kesime etkiyen kuvvetlerin, taşıma katsayısı, sürükleme katsayısı ve hücum açısı

kullanılarak ifade edilmesidir.

### 5.4.1 Momentum Teorisi

Momentum teorisiyle, rotor üzerinde çembersel bir alanda eksenel ve açısal indüksiyon

faktörlerinin fonksiyonu olarak tanımlanmış itki ve tork ifadeleri elde edilir.

Türbin kanadına etkiyen kuvvetler, kuvvetin momentum değişim oranı olmasından ötürü, momentum korunumu ilkesiyle belirlenebilir. İlgili denklemler 3.2 bölümünde çıkarılmıştır.

Burada yapılacak analiz, Şekil 1’de gösterilen çembersel kontrol hacmi üzerinden yapılacaktır.

Eksenel ve açısal indüksiyon faktörlerinin, yarıçap r ’nin bir fonksiyonu olduğu kabul

edilmiştir.

Doğrusal momentumun korunumu prensibinin r yarıçaplı dr kalınlıklı bir kontrol hacmine

uygulanması itkiye yapılan diferansiyel katkı için bir ifade verir:

dT = ρU

24a(1 − a)πrdr | (3.40)

Kanatlara aktarılmış diferansiyel tork ifadesi (3.28)’de verilmişti:

dQ = 4a

′
(1 − a)ρUπr
3Ωdr | (3.28)

### 5.4.2 Kanat Eleman Teorisi

Bir kanada etkiyen kuvvetler CL

, CD ve α’nın fonksiyonu olarak ifade edilebilir. Aşağıdaki

şekilde görüldüğü üzere, kanat N sayıda elemana bölünmüş kabul edilecektir. Diğer kabuller

şu şekildedir:

- Elemanlar arası aerodinamik etkileşim yoktur.
- Her bir eleman üzerine etkiyen kuvvet yalnızca kanat profilinin taşıma ve sürükleme

karakteristiklerince belirlenir.


Kuvvet analizi yapılırken, taşıma kuvvetinin bağıl rüzgar hızına dik, sürükleme kuvvetininse

bapıl rüzgar hızına parallel olduğu unutulmamalıdır. Bağıl rüzgar hızı, rotor civarındaki rüzgar

hızı U(1 − a) ve rotorun dairesel hareketinden kaynaklı rüzgar hızının vektörel toplamıdır. Bu dairesel bileşen, kanat elemanının çizgisel hızı Ωr ve kanatlardak indüklenmiş açısal hız ωr
2

’nin

vektörel toplamdır. Tüm bu anlatılanlar aşağıdaki ifadeye denk gelir:

Ωr +

ωr
2

= Ωr + Ωa

′
r = Ωr(1 + a′) | (3.41)


Şekil 12: Analizde kullanılacak kanat geometrisi ve notasyonlar

Şekil 11: Kanat Eleman Teorisinde kullanılacak kanat modeli

Şekil 7’de θp veter çizgisi ile rotor yüzeyi arasındaki açı; θp,0, kanat ucu pitch açısı; θT ,

burulma açısı; α, hücum açısı; φ, bağıl rüzgar açısı; dFL

, elemandaki sürükleme kuvveti; dFN,

dönme yüzeyin dik kuvvet; dFT ise rotorun çizdiği çembere teğet kuvvettir. Bu kuuvet, işe

yarar torku üreten kuvvettir. Son olarak, Ubağıl, bağıl rüzgar hızıdır.

Burada, kanat burulma açısı θT kanat ucu referans alınarak tanımlanmıştır. Aşağıdaki ifade θT

ifadesidir.

θT = θP − θP,0 | (3.42)

3.42 ifadesinde θP,0 ifadesi kanat ucundaki pitch açısıdır.

Burulma açısı kanat geometrisinin bir fonksiyonudur; ilerleyen bölümlerde kanat boyunca

burulma açısının dağılımı çıkarılacaktır. θP değiştiğinde θP,0 açısı da değişecektir. Ayrıca,

bağıl rüzgar açısı φ, eleman pitch açısı θP ve hücum açısı α’nın toplamıdır:

φ = θP + α | (3.43)

Aşağıdaki ifadeler, şekilden çıkarılmıştır:

tanφ =

U(1−a)
Ωr(1+a′)

=

1−a
(1+a′)λr | (3.44)

Ubağıl =

U(1−a)
sinφ

(3.45)

dFL = CL0.5ρUbağıl

2
cdr | (3.46)

dFD = CD0.5ρUbağıl

2
cdr | (3.47)
dFN = dFLcosφ + dFDsinφ | (3.48)
dFT = dFLsinφ − dFDcosφ | (3.49)

Toplam kanat sayısı B olsun. Bu durumda merkezden r uzaklığındaki eleman üzerindeki dik

kuvvet aşağıdaki ifadedir:

dFN =

1
2

BρUbağıl

2
(CLcosφ + CDsinφ)cdr | (3.50)

Merkezden r uzaklığındaki bir eleman üzerindeki teğetsel kuvvet tarafından eleman üzerine

uygulanan diferansiyel torkaşağıdaki ifadedir:

dQ = BrdFT | (3.51)

dFT yerine yazıldığında tork ifadesi aşağıdaki hali alır:

dQ =

1
2

BρUbağıl

2
(CLsinφ − CDcosφ)crdr | (3.52)

Sürükleme kuvvetinin torku ve akabinde gücü düşürdüğüne, ancak itki yüklemesini artırdığına

dikkat ediniz.

Kanat eleman teorisi de momentum teorisi gibi iki denklem verir: 3.50 ve 3.52. Bu iki denklem,

rotor üzerinde çembersel bir alanda, akış açıları ve profil karakteristiği fonksiyonu olarak, dik

kuvveti (itki kuvveti) ve teğetsel kuvveti (tork) tanımlar.Bu denklemler daha sonra optimum

performansı verecek ideal kanat şeklini bulmak için kullanılacaktır.

### 5.5 Dönel Akışın İhmal Edildiği Şartlarda İdeal Kanat Geometrisi ve Kanat Elemanı

Momentum Teorisi [17]

Momentum teorisi ve kanat eleman teorisi denklemleri, kanat şeklini rotor performansı ile

ilişkilendirmek amacıyla kullanılabilir. Burada gösterilecek olan örnek, cebirsel kısmın

karmaşıklaşmaması adına basit olacaktır.

Bu bölümün başlarında sürüklemenin ve dönel akışın olmadığı kabulüyle yapılan

hesaplamalarda, türbinin maksimum güç katsayısının, eksenel indüksiyon faktörü a =

1
3
olduğunda elde edildiği görülmüştür. Aynı kabuller kanat elemanı ve momentum teorisine

uygulandığında analiz ideal kanat şeklini belirlemek için yeterince basit bir hal alır. Burada

çıkarılacak kanat geometrisi, tasarlanığı uç hız oranında çalışan bir türbinde kullanılırsa

maksimum verime yakın verimdeğerleri elde edilir.

Analizde aşağıdaki kabuller de yapılmıştır:

- Dönel akış yoktur: a

′ = 0

- Sürükleme kuvveti yoktur: CD = 0

- Kanat sayısının sonlu olmasından ötürü ortaya çıkan kayıplar yoktur.
- Betz optimum rotoru için, her çembersel akış tübünde a =

1
3

’tür.

Tasarıma başlamadan önce uç hız oranı λ, kanat sayısı B, yarıçap r ve CL

(α) ve CD(α)

grafikleri bilinen bir kanat profili seçilmelidir (Şekil 5’e bakınız). Kanat profilinin tabi olacağı

hücum açısı da seçilmelidir (CL(α)/CD(α) değerinin en yüksek olduğu α açısı). Bu seçimler,

Betz limitinde güç üretimi sağlayacak veter ve burulma dağılımının bulunmasını mümkün kılar.

a =

1
3

kabulüyle momentum teorisinden aşağıdaki sonuç bulunur:

dT = ρU

24 (

1
3

) (1 −

1
3

) πrdr =

8ρU

2πrdr

9

(3.53)

CD = 0 olduğundan 3.50 numaralı denklem aşağıdaki hale dönüşür:

dFN =

1
2

BρUbağıl

2 | CLcosφcdr | (3.54)

a =

1
3

, 3.45 denkleminde yerine yazıldığında, denklem şu hale dönüşür:

Ubağıl =

U(1−a)
sinφ

=

2U
3sinφ

(3.55)

Kanat elemanı momentum teorisi, momentum teorisi ve kanat eleman teorisini bir araya

getirerek kanat performansının kararlaştırılmasına dayanır. Bu durumda 3.53’ün 3.54’e

eşitlenmesi ve 3.55’in kullanılması şu sonucu verir:

CLBc
4πr
= tanφ sinφ | (3.56)

a

′
, a ve φ ’yi geometrik hesaplarla ilişkilendiren 3.44 denklemi, kanat geometrisinin

belirlenmesi amacıyla a

′ = 0 ve a =

1
3

kabulleri yerine konularak çözülürse aşağıdaki ifade

elde edilir:

tanφ =

2
3λr

(3.57)

Dolayısıyla, aşağıdaki ifadeyi yazmamak için ortada bir sebep kalmaz:

CLBc
4πr

=

2
3λr
sinφ | (3.58)

λr = λ

r
R

olduğu göz önünde bulundurulup denklemler yeniden yazıldığında, ideal türbin için

bağıl rüzgar açısı ve veter uzunluğu arasındaki ilişki bulunur:

φ = tan⁻¹

2
3λr

(3.59)

c =

8πr sinφ
3BCLλr

(3.60)

Böylece, Betz optimum kanadı için kanat boyu veter uzunluğu ve burulma açısı dağılımı

ifadeleri bulunmuş olur. Örneğin; λ = 7, r = 5 m , CL = 1,

CL
CD

değeri α = 7° değerinde

maksimum olan ve kanat sayısı B = 3 olan bir rotor tasarlıyoruz. Burulma açısı dağılımı v eve

veter uzunluğu dağılımı Şekil 8’de görülebilir

Grafikler incelendiğinde, ideal rotor tasarımında, rotor merkezine doğru veter uzunluğunun ve

burulma açısının arttığı görülür. Ancak ideal kanat üretmenin zor ve maliyetli oluşu, kanat tasarımcılarını ideale en yakın, üretimi ucuz ve kolay rotorlar tasarlamaya zorlar.. Örneğin,

doğrusal olmayan veter dağılımı yerine doğrusal veter dağılımı, aynı şekilde doğrusal burulma

açısı dağılımı tercih edilebilir.

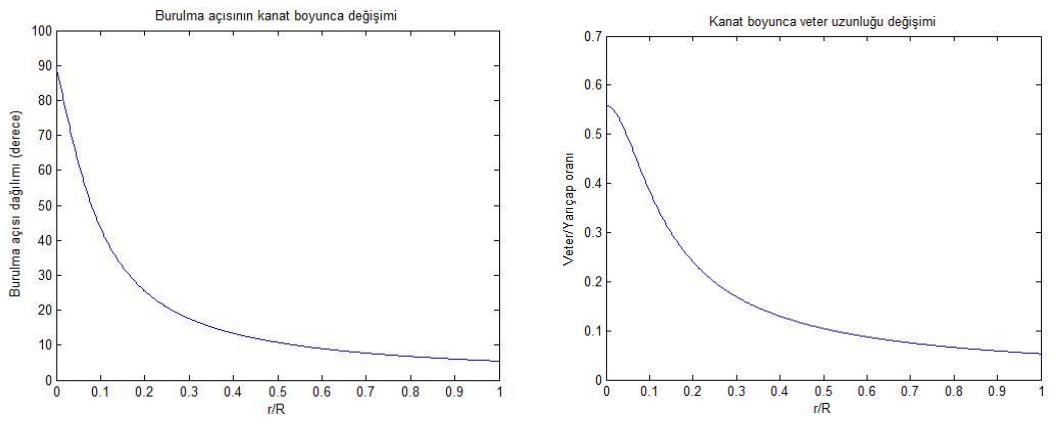
[picture p84: figure]

Şekil 13: Veter uzunluğu ve burulma açısı kanat boyu dağılımları

Daha küçük yarıçaplı türbin tasarlamak istendiğinde(örneğin 1 metre yarıçaplı), kök veteri

yarıçapın birkaç katına çıkmaktadır. Aşağıdaki şekilde yarıçapı 1 metre olan rotor için veter ve

burulma açısı dağılımı görülebilir.

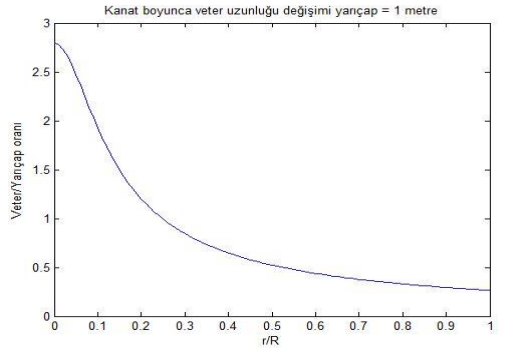
[picture p85: figure]

Şekil 14: Yarıçapı 1 metre olan türbinin veter uzunluğu dağılımı

### 5.6 Dönel Akışlı Optimum Rotor için Kanat Şekli [18]

Dönel akışın etkilerinin hesaba katıldığı kanat tasarımı, bir önceki kısımda bulunan yöntemler

kullanılarak çıkarılacaktır. Bu kısımda sürükleme katsayısı ve kanat ucu kayıpları tekrar ihmal

edilecek (CD = 0, F = 1), türbin parametreleri bir önceki bölümde verilenlerle aynı seçilecek

ve elde edilen sonuçlar karşılaştırılacaktır.

Optimizasyon kısmı, CP integralinde (de Vries, 1979), bağıl rüzgar açısı φ’nin fonksiyonu olan

parçanın φ’ye kısmi türevinin alınıp sıfıra eşitlenmesiyle başlar:

∂
∂φ
[sin² φ(cosφ − λrsinφ)(sinφ + λrcosφ)] = 0 | (3.61)

Bu işlem sonucu λr

,φ ve c için aşağıdaki ifadeler elde edilebilir:

λr =

sinφ(2cosφ−1)
[(1−cosφ)(2cosφ+1)]

(3.62)

φ =

2
3

tan⁻¹

1
λr

(3.63)

c =

8πr
BCL
(1 − cosφ) | (3.64)

İndüksiyon faktörleri aşağıdaki ifadelerden bulunabilir:

a

′ =

1−3a
4a−1

(3.65)

a =

1
[1+4 sin² φ/σ′CLcosφ]

(3.66)

3.66 denkleminde bulunan σ′ ifadesi, bölgesel katılık oranıdır ve aşağıdaki şekilde tanımlanır:

σ

′ =

Bc
2πr

(3.67)

3.65 ve 3.66 denklemleri burulma ve veter uzunluğu dağılımı fonksiyonlarıdır. 3.5

bölümündeki örnek yeniden analiz edildiğinde aşağıdaki grafikler elde edilir.

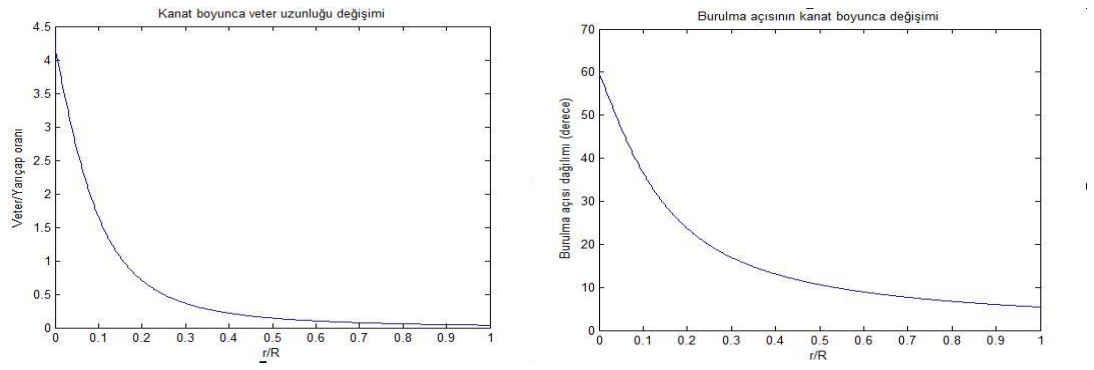
[picture p86: figure]

Şekil 15: Dönel akışlı türbinin veter ve burulma dağılımı

### 6. PID KONTROL

Bir sistemin, uygulama gereksinimlerine göre tepki vermesi istenir. Tepkinin gereksinime

uyarlanması ise kontrol sistemleri tarafından yapılır. PID kontrol algoritması yaygın olarak

kullanılan bir yöntemdir. Aşağıdaki ifade, PID algoritmasının matematiksel ifadesidir [19]:

u(t) = P (e(t) +
1
I

∫ e(τ)dt t
0

+ D

d
dt
e(t)) | (6.1)

u(t) , sisteme uygulanan kontrol sinyali, e(t) sistem hatasıdır. Kontrol sinyali üç terimin

toplamıdır: P terimi (hatayla doğtu orantılı), I terimi (hatanın integrali ile doğru orantılı) ve D

terimi (hatanın türevi ile doğru orantılı).

### 6.1 Tek Serbestlik Dereceli İkinci Derece Sistem Tepkisi

Kütle, yay ve sönümleyici elemandan oluşan bir sistem aşağıdaki diferansiyel denklem ile

verilir:

y(t) = mẍ(t) + cẋ(t) + kx(t) | (6.2)

Sistemin zaman alanındaki modeli olan bu denklem, Laplace dönüşümü alınarak frekans

alanındaki modeli (transfer fonksiyonu) elde edilir:

Y(s) X(s)
=
1 ms 2+cs+k | (6.3)

6.3 denkleminde X(s), sistemin tepkisinin frekans alanındaki modeli, Y(s) ise sisteme

uygulanan girişin frekans alanındaki modelidir. çıkış/giriş formatında olan transfer

fonksiyonu ile sisteme uygulanacak giriş fonksiyonun frekans alanındaki modeli skaler olarak

çarpılırsa sistem cevabının frekans alanındaki modeli elde edilir. Ters Laplace Dönüşümü

uyglanarak zaman alanında sistem cevabı bulunabilir.

U(s) ∗

Y(s) X(s)
=
U(s) ms 2+cs+k | (6.4)

L

−1

{U(s) ∗

Y(s)
X(s)

} = L
−1

{

U(s)
ms

2+cs+k

} | (6.5)

### 6.2 Sistem Basamak Cevabı

Zaman içinde değişmeyen kuvvet, tork, voltaj, basınç vs. basamak girişi olarak anılır.

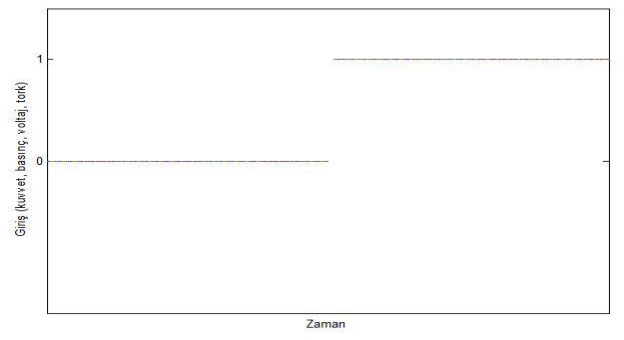
[picture p87: figure]

Şekil 16: t = 0’dan sonra sisteme uygulanmış basamak fonksiyonu

İkinci derecen tek serbestlik dereceli bir sistemin basamak cevabı, sistem içeriğine göre

değişiklik gösterir. Kütle, atalet, kapasitans, direnç, yay vs. değerleri sistemin tepkisini

etkileyen öğelerdir ancak genel olarak sistem tepkisi üç başlık altında incelenebilir:

1. Düşük sönümlü sistem
2. Kararlı sönümlü sistem
3. Aşırı sönümlü sistem

Sistemlerin sönüm durumları, karakteristik polinomlarının diskriminantına bakılarak karar

verilir:

Δ = c

2 − 4km | (6.6)
1. Düşük sönümlü sistemler Δ < 0 şartını sağlarlar.

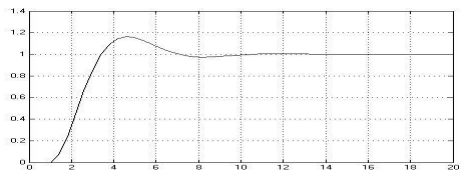
[picture p88: figure]

Şekil 17: Düşük sönümlü sistemin basamak cevabı

2. Kararlı sönümlü sistemler Δ = 0 şartını sağlarlar.

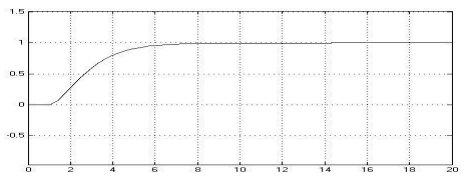
[picture p89: figure]

Şekil 18: Kararlı sönümlü sistemin basamak cevabı

3. Aşırı sönümlü sistemler Δ > 0 şartını sağlarlar.

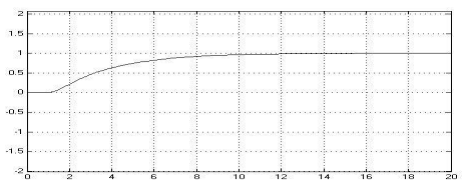
[picture p90: figure]

Şekil 19: Aşırı sönümlü sistemin basamak cevabı

Düşük sönümlü sistemler, geçici tepki sırasında denge noktasını aşarlar. Kararlı sönümlü

sistemler ise denge noktasının aşılmasını engelleyecek en düşük c sönümleme katsayısına

sahiptirler. Bu değerden daha büyük c katsayısına sahip sistemlere aşırı sönümlü sistemler

denir.

### 6.3 P, I ve D Katsayılarının Sistem Tepkisine Etkisi

Kontrolör katsayılarının sistem tepkisi üzerinde farklı etkileri vardır. P katsayısı, sistemin

kararlı durum hatası ve yükselme zamanı üzerinde etkilidir; I katsayısı kararlı durum hatasını P

katsayısının kabul edilebilir aşım değerleri içinde indiremeyeceği noktalara indirir; D katsayısı

ise denge noktasının aşımını engelleyici etkide bulunur. P, I ve D katsayıları çeşitli

optimizasyon algoritmaları ile (Ziegler – Nichols vs.) en iyi değerlerine çekilebilir.

P etkisi

P katsayısı arttıkça kararlı durum hatası azalmakta ancak sistemin tepkisinin ulaştığı tepe

noktası da yükselmektedir. I katsayısı eklemek aşım sorunun ortadan kaldırıp kararlı durum

hatasını en aza indirir.

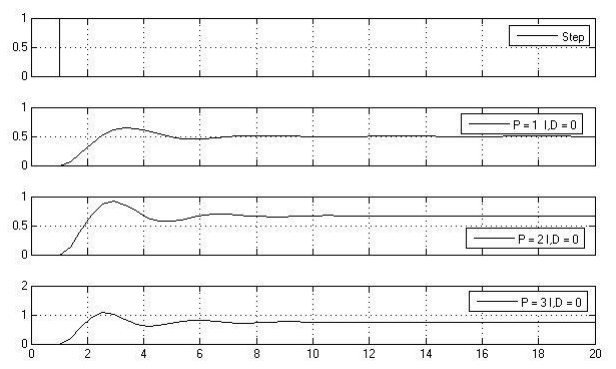
[picture p91: figure]

Şekil 20: Düşük sönümlü sistemin farklı P katsayılarına tepkisi


Şekil 21: P katsayısının kararlı sönümlü sistem üzerine etkisi

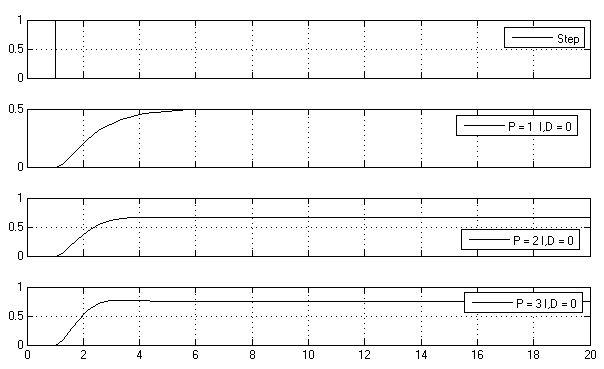
[picture p92: figure]

Şekil 22: P katsayısının aşırı sönümlü sistem üzerine etkisi

I etkisi

I katsayısı, kararlı durum hatasını ortadan kaldırır.Ancak I katsayısı sistem üzerindeki etkisi

yay katsayısı gibidir Bu sebeple hatalı yapılacak optimizasyon sistemi rezonansa sokabilir.

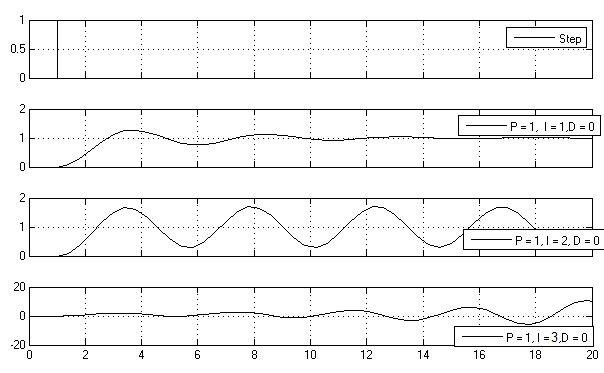
[picture p93: figure]

Şekil 23: I katsayısının düşük sönümlü sistem üzerine etkisi

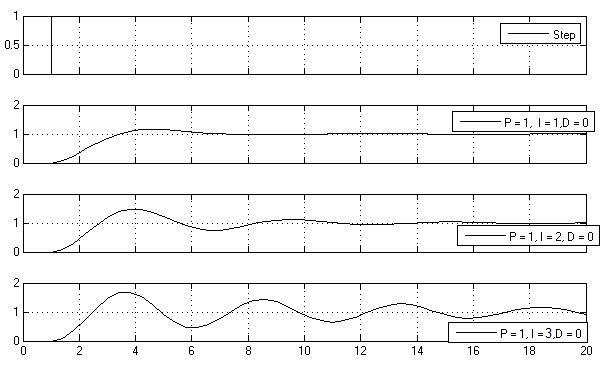
[picture p94: figure]

Şekil 24: I katsayısının kararlı sönümlü sistem üzerine etkisi

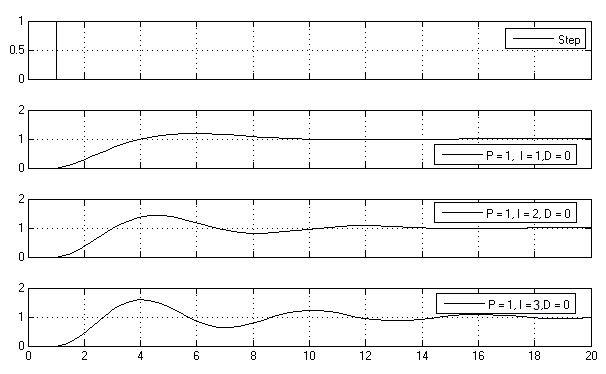
[picture p95: figure]

Şekil 25: I katsayısının aşırı sönümlü sistem üzerine etkisi

D etkisi

D katsayısı, hatanın türevini alır; bir nevi hatanın kapanma hızını gösterir. D katsayısı tepki

aşımını ve salınımı ortadan kaldırır.


Şekil 26: D katsayısının düşük sönümlü sistem üzerine etkisi


Şekil 27: D katsayısının kararlı sönümlü sistem üzerine etkisi

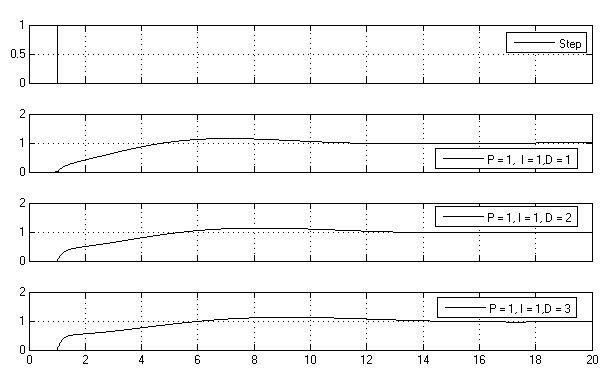
[picture p96: figure]

Şekil 28: D katsayısının aşırı sönümlü sistem üzerine etkisi

### 8. TASARIM

### 8.1 Rotor Tasarımı

Rotor parametreleri aşağıdaki gibi seçilmiştir:

1. Kanat profili: NACA5518
2. λ uç hız oranı = 7
3. Kanat sayısı = 5
4. α hücum açısı = 4.5
5. Rotor yarıçapı = 1 metre


Şekil 29: Veter uzunluğu dağılımı grafiği


Şekil 30: Burulma açısı dağılımı grafiği

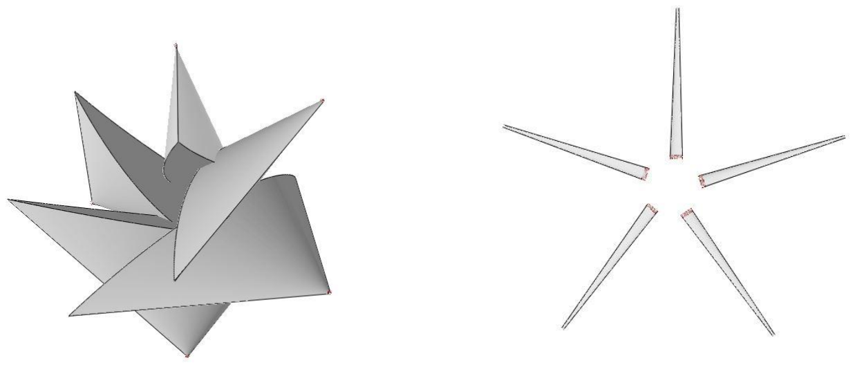
[picture p97: figure]

Şekil 31: Elde edilen verilerle oluştulan rotor

Şekil 32: QBlade'in optimizayonu sonucu elde edilen rotor

Optimize edilmiş kanat verileri aşağıdaki gibidir:

Kök veter: 8.4 cm Kök burulma açısı: -1.3

0

Uç veter: 1.6 cm Uç burulma açısı: 20⁰

### 8.2 Elektrik ve Elektronik Tasarım

EAGLE 7.5 programında, projeye özel bir devre kartı tasarlanmıştır. Kart şematiği Şekil 34’te

görülebilir. Tasarımın yalnızca prototip olduğunu, nihai tasarım olmadığını belirtmek isterim.

### 8.2.1 Denetleyici

Türbin denetleyicisi olarak Seeeduino Arch Pro kartı kullanılacaktır. 32 bit ARM Cortex M4

tabanlı NXP LPC1768 mikrodenetleyicisinden faydalanan bu kart farklı projelerde de

kullanılacak şekilde tasarlanmıştır. Proje için tasarlanmış olan kart şematiği bir sonraki sayfada

görülebilir.

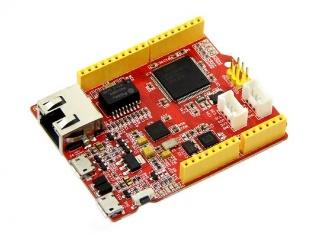
[picture p98: figure]

Şekil 33: Seeeduino Arch Pro

32 bit LPC1768 denetleyicisinin avantajları şu şekildedir:

1. Küsüratlı işlemlerde daha hızlı ve isabetli sonuçlar elde edilir.
2. Multithreading ile aynı anda birden fazla komut işlenebilir.
3. 96 MHz çalışma frekansı birçok gerçek zamanlı uygulama için gerekenden yüksek bir

hızdır.

4. 512 KB hafıza ile daha büyük programlar yazılabilir.
5. Geniş kütüphane ve topluluk desteği sunar.
6. Enkoderler için özelleşmiş arayüz kullanırlar.

### 8.2.2 Eyleyici ve Sürücüler

Yaw ekseninde yüksek torklu step motor, pitch ekseninde yüksek torklu mikro servo motor

kullanılacaktır. Step motorlar, konum geri bildirimi yapılmadan, adımları sayılarak konum

kontrolüne olanak sağlarlar. Ancak adım kaçması durumunda hatalı sonuçlar elde edilir.

Mikro servo motor, kendi içinde kontrol mekanizması bulunan, potansiyometre ile pozisyon

ölçümü yapan bir eyleyicidir. Ayrıca kendi bünyesinde motor sürücüsünü de barındırır.

Tepkileri oldukça hızlı ve isabetlidir. Aşım yapmadan ve son derece hızlı bir şekilde istenen

konuma gelirler. Tek yapılması gereken, PWM arayüzü kullanarak servo motor ile iletişim

kurmaktır.

### 8.2.3 Sensörler

Sensörler, kontrol değişkenlerinin denetleyici tarafından algılanmasını sağlarlar. Ölçümü

yapılacak değişkenler rüzgar hızı ve rüzgar yönüdür. Rüzgar hızı sensörü olarak encoder, rüzgar

hızı sensörü olarak ise pitot tübü kullanılacaktır. Enkoder ile denetleyici, denetleyicinin

sunduğu QEI (Quadrature Encoder Interface) aracılığıyla haberleşecektir.

Pitot tübü, 0.5V – 4.5V arası çıkış vermektedir. Denetleyici 3.3V mantık seviyesiyle

çalıştığından, pitot tübünün çıkış gerilimi 3.3V ile sınırlandırılmalıdır. Bu noktada

uygulanabilecek pek çok konfigürasyon mevcuttur. Maliyet, üretim kolaylığı ve öğreticilik

seviyesine göre bir konfigürasyon seçilecek ve uygulanacaktır.

Rüzgar hızı sensörü olarak endüstriyel anemometerlerden de faydalanılabilir. Ancak standard

anemometre boyutları ile tasarlanan türbinin boyutları orantılı değildir. Bu sebeple pitot tübü

kullanmak daha mantıklı gözükmektedir.

### 8.3 Algoritma ve Denetleyici Tasarımı

Denetleyici tasarımı, türbin bilgisayar ortamında mekanik olarak modellenmesinin ardından

yapılacaktır. Denetleyici tasarımı, sistem tepkisi beklentilerinin belirlenmesinin ardından P, I

ve D katsayılarının belirlenmesi ile başlayacak ve uygulamadaki performansının ölçülmesi ve

akabinde yapılacak iyileştirmelerle devam edecektir. Sistemin kaba blok diyagramı Şekil

34’teki gibidir:

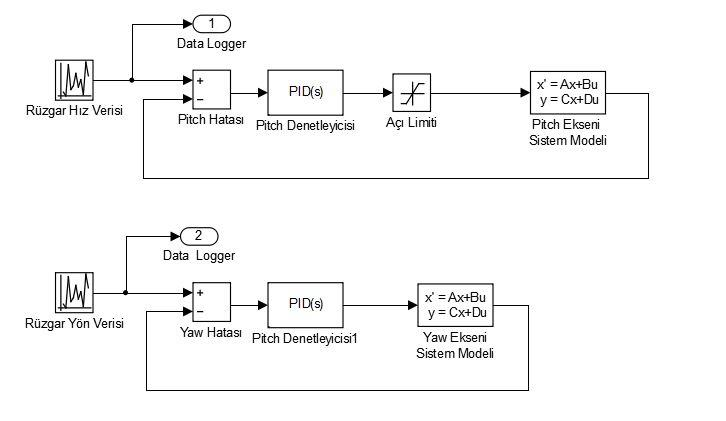
[picture p99: figure]

Şekil 34: Sistemin kaba blok diyagramı

### 8.4 Elektrik Üretimi

Ticari türbinlerde elektrik üretimi üç fazlı jeneratörlerle yapılmaktadır. Bizim projemizde ise

boyut ve bütçe göz önüne alındığında fırçalı doğru akım motoru kullanılması uygun

görülmüştür. Seçilen motor 80 devirde 12V 3.6W güç vermektedir; redüktörlü ve enkoderli

oluşu sebebiyle uygun görülmüştür. Ayrıca elde edilecek doğru akım ile LED yakma ve batarya

şarj etme gibi işlemler yapılabilir.

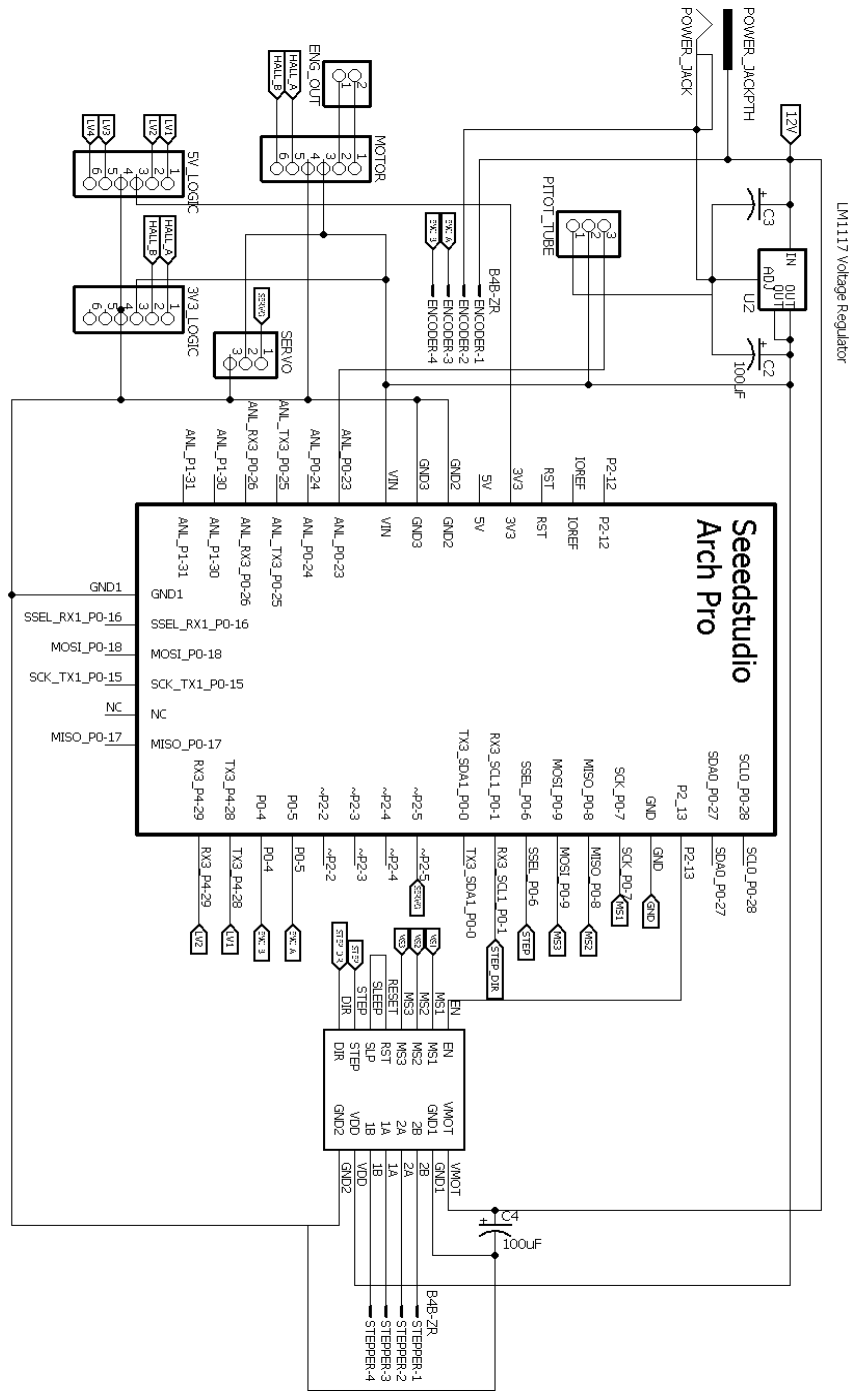
[picture p100: figure]

Şekil 35: Kart şematiği

### 9. BÜTÇE

Tübitak 2241-A programına yapılan başvuru olumsuz neticelenmiştir. Kişisel kaynaklarla proje

finanse edilecektir. Projenin bütçesi 700 Türk Lirası’dır.

### 9.1 Malzeme Listesi

Görevi | Malzeme | Fiyat | Açıklama
Denetleyici | LPC1768 tabanlı Seeeduino Arch Pro | Hali hazırda mevcut
| PowerHD Alüminyum Dişlili Mikro Dijital Servo Motor - HD-DSM44 (http://www.robotistan.com/powerhd-aluminyum-dislili-mikro-dijital-servo-motor-hd-dsm44) | 53.29 TL
| NEMA 23 200 Adım 57x56mm 7.4V Step Motor (http://www.robotistan.com/nema-23-200-adim-57x56mm-74v-step-motor) | 75.64 TL
DC Jeneratör | 12V 37mm 80 Rpm Enkoderli 131:1 Redüktörlü DC Motor (http://www.robotistan.com/12v-37mm-80-rpm-enkoderli-1311-reduktorlu-dc-motor-1311-metal-gearmotor) | 136.50 TL

Eyleyici

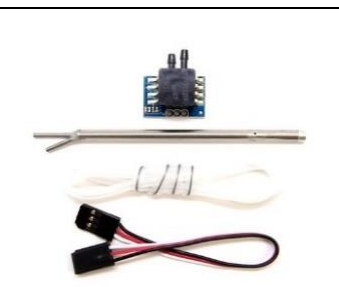
[picture p101: figure]

Rüzgar hızı sensörü | APM 2.6 Airspeed Kit -MPXV7002DP | Hali hazırda mevcut
Rüzgar yön sensörü | 600 p/r kuadratür enkoder | Hali hazırda mevcut

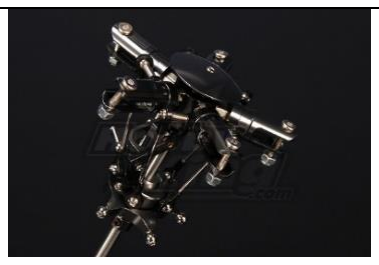
[picture p102: figure]

Rotor merkezi | 5 pervaneli model helicopter rotor başı | 26.15$

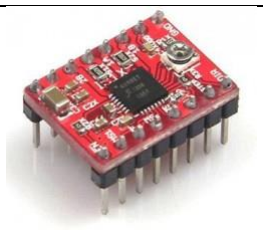
[picture p103: figure]

Sürücü Kartı | A4988 Step Motor Sürücü Kartı (http://www.robotistan.com/a4988-step-motor-surucu-karti-kirmizi-pcb) | 16.50 TL

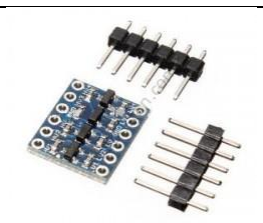
[picture p104: figure]

Lojik seviye dönüştürücü | Lojik Gerilim Seviyesi Dönüştürücü (3.3V-5V) (http://www.robotistan.com/lojik-gerilim-seviyesi-donusturucu-33v-5v-logic-level-converter-bi-d) | 9.50 TL | Denetleyici 3.3V lojik gerilimle çalışmaktadır; denetleyicinin sensörlerle iletişimi için gereklidir.

### 9.2 Hizmet Alımları

Kontrol kartı için baskı devre hizmeti, ayrıca encoder için tasarlanacak dikey sabitleyici için

3B baskı hizmeti alınacaktır.

### 10. ÇALIŞMA TAKVİMİ

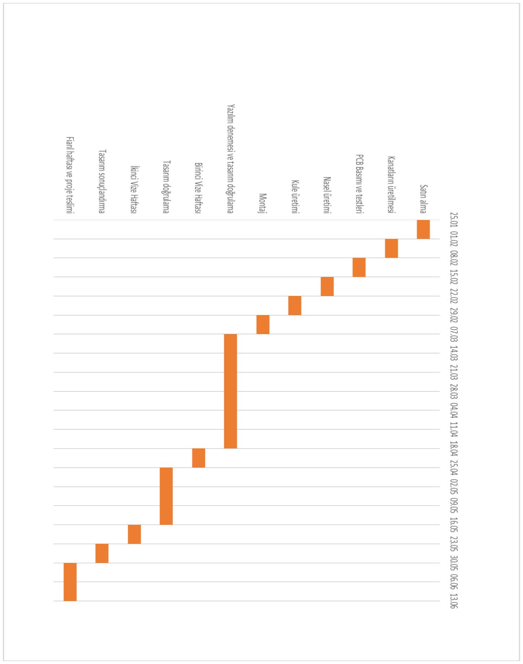
[picture p105: figure]

Şekil 36: Proje takvimi

### 11. SONUÇLAR ve ÖNERİLER

Tasarım kabaca hazır ancak teorik olarak bilgi eksikliği hala yerini korumakta. Öncelikle, kanat

hakkındaki teorik sonuçların neden uygulamada imkansız sonuçlar verdiği anlaşılmalıdır.

Ayrıca, simülasyon konusunda daha ileri gidilmeli, daha elle tutulur ve sunulabilir veriler elde

edilmelidir. Ayrıca yaw dişlisi tasarımı üzerine çalışma yapılmamıştır. Bu konuda literatür

taranmalı ve çeşitli tasarımlar içinden uygun olan seçilmelidir.

Devre kartı tasarımı nihai haline getirilmelidir. Numuneler basılmalı ve denemelere çalışma

takvimi kapsamında başlanmalıdır.

Algoritma ve yazılım geliştirme kısmına çalışma takviminde en uzun vakit ayrılmıştır. Projede

asıl odaklanılacak nokta algoritma olduğundan böyle bir karar alınmıştır.

Kaynakça

[1] TÜREB, «Türkiye Rüzgar Enerjisi İstatistik Raporu Ocak 2015,» Türkiye Rüzgar

Enerjisi, 2015.

[2] R. J. C. Peter J. Schubel, «Wind Turbine Blade Design,» Energies, pp. 3425-3449, 2012.
[3] A. B. Ş. B. Murat Gökçek, «Investigation of wind characteristics and wind energy

potential in Kırklareli, Tukey,» ScienceDirect Renewable Energy, pp. 1739-1752, 2007.

[4] J. M. A. R. J.F. Manwell, «1.1 Modern Wind Turbines,» Wind Energy Explained Theory,

Design and Application, West Sussex, Wiley, 2002, p. 2.

[5] «Kaffee Mühle,» 28 12 2015. http://www.muehle-bremen.de/images/gallery/11.jpg.

[Erişildi: 28 Aralık 2015].

[6] J. M. A. R. J.F. Manwell, «1.2.2 Early wind generation of electricity,» Wind Energy

Explained Theory, Design and Application, West Sussex, Wiley, 2002, p. 14.

[7] «Euronews Haber,» Euronews, 25 Aralık 2015.

http://tr.euronews.com/2015/12/24/kirmizi-alarm-hava-kirliligi-dunya-geneline-yayildi/.

[Erişildi: 26 Aralık 2015].

[8] «Euronews Haber,» Euronews, 29 Aralık 2015.

http://tr.euronews.com/2015/12/29/milan-da-rekor-hava-kirliligine-radikal-cozum/.

[Erişildi: 29 Aralık 2015].

[9] IEA Wind, «2014 Annual Report,» International Energy Agency, 2015.
[10] GWEC, «Global Wind Energy Council,»

http://www.gwec.net/wp-content/uploads/2012/06/Annual-Installed-Capacity-by-

Region-2006-2014.jpg. [Erişildi: 29 Aralık 2015].

[11] H. A. Cumali İlkkılı., «Wind power potential and usage in the coastal regions of Turkey,»

Renewable and Sustainable Energy Reviews, pp. 78-86, 2015.

[12] Y.-L. T. Tsang-Jung Chang, «Evaluation of monthly capacity factor of WECS using

chronological and probabilistic wind speed data: A case study of Taiwan,» ScienceDirect

Renewable Energy, pp. 1999-2010, 2007.

[13] A. N. Çelik, «Energy output estimation for small-scale wind power generators using

Weibull-representative wind data,» Journal of Wind Engineering and Industrial

Aerodynamics, pp. 693-707, 2003.

[14] «3.2 One Dimensional Momentum Theory,» Wind Energy Explained Theory, Design and

Application, West Sussex, Wiley, 2002, p. 84.

[15] «3.3 Ideal Horizontal Axis Wind Turbine with Wake Rotation,» Wind Energy Explained

Theory, Design and Application, West Sussex, Wiley, 2002, p. 89.

[16] «3.5 Momentum Theory and Blade Element Theory,» Wind Energy Explained Theory

Design and Applicaiton, West Sussex, Wiley, 2002, p. 105.

[17] «3.6 Blade Shape for Ideal Rotor without Wake Rotation,» Wind Energy Explained

Theory, Design and Application, West Sussex, Wiley, 2002, p. 110.

[18] «3.8 Blade Shape for Optimum Rotor with Wake Rotation,» Wind Energy Explained

Theory Design and Application, West Sussex, Wiley, 2002, p. 122.

[19] T. H. Karl. J. Astrom, «3.2 The PID Controller,» Advanced PID Control, North Carolina,

The Instrumentation, Systems and Automation Society, 2006, p. 64.
