mettinoktay/Final_Thesis/Design/Final Assembly/Generator and Holder ASM.SLDASM

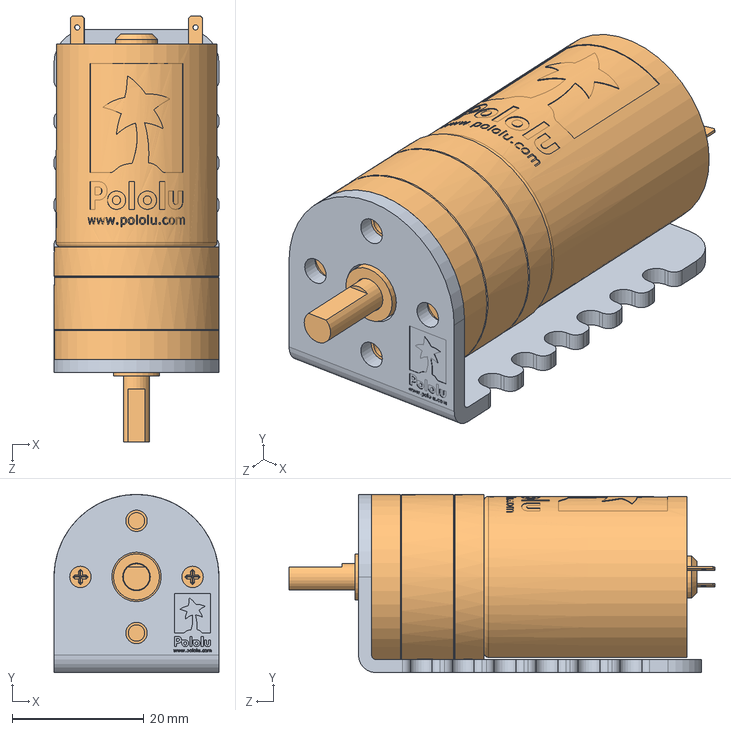
[picture p106: CAD file, 2016-06-03]
Design/Final Assembly/Generator and Holder ASM.SLDASM
25.0 x 27.0 x 64.5 mm
Generator Holder
Generator
