mettinoktay/Final_Thesis/Design/Final Assembly/RulmanTutucu.SLDPRT

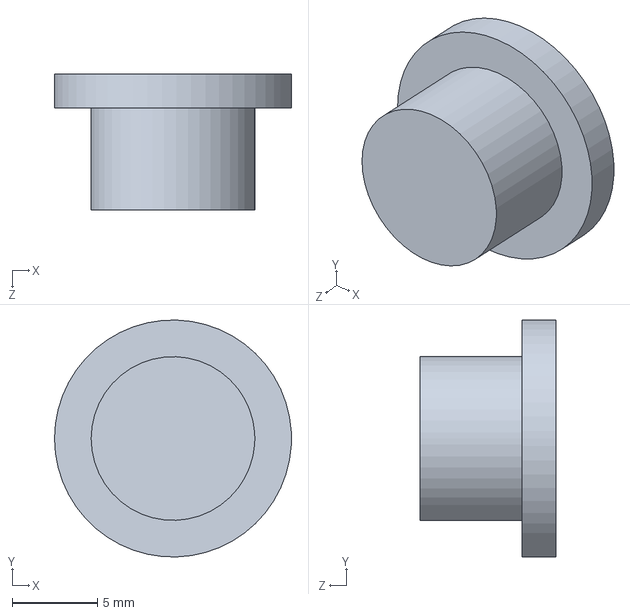
[picture p107: CAD file, 2016-07-19]
Design/Final Assembly/RulmanTutucu.SLDPRT
13.9 x 13.9 x 8.00 mm
