mettinoktay/Final_Thesis/Design/Final Assembly/Step Dosyaları/RulmanTutucu.STEP

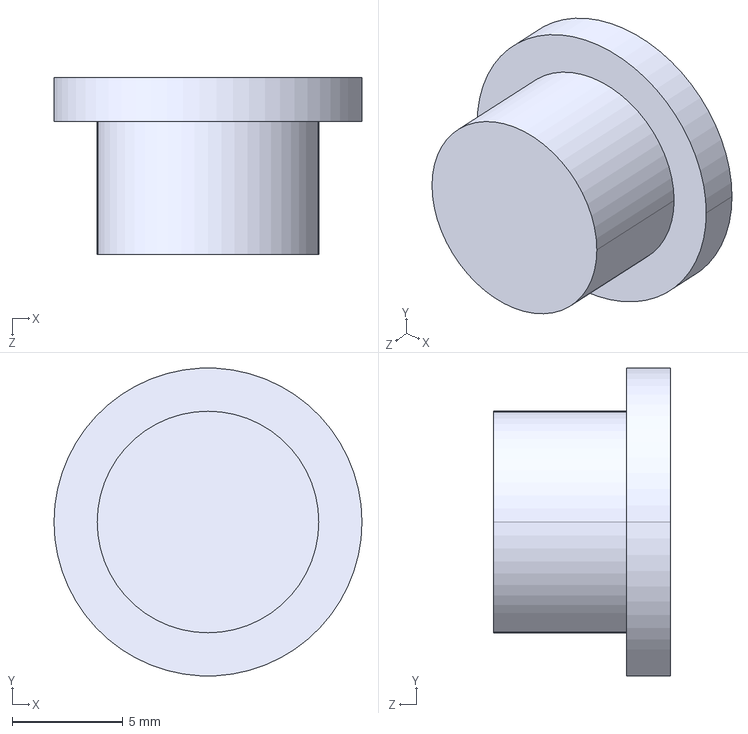
[picture p108: CAD file, 2016-06-03]
Design/Final Assembly/Step Dosyaları/RulmanTutucu.STEP
13.9 x 13.9 x 8.00 mm
