mettinoktay/Final_Thesis/Design/Final Assembly/Step Dosyaları/Wind Vane.STEP

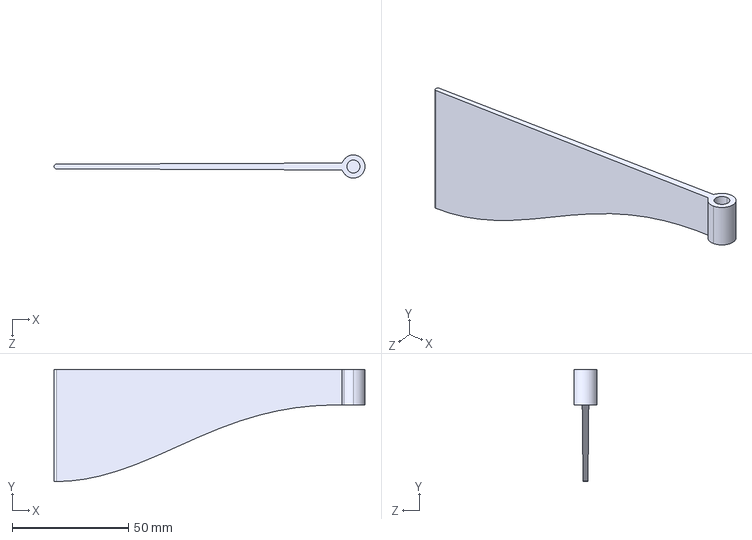
[picture p109: CAD file, 2016-06-03]
Design/Final Assembly/Step Dosyaları/Wind Vane.STEP
133.9 x 48.3 x 10.0 mm
