mettinoktay/Final_Thesis/Design/Final Assembly/Mil Uydurucu.SLDPRT

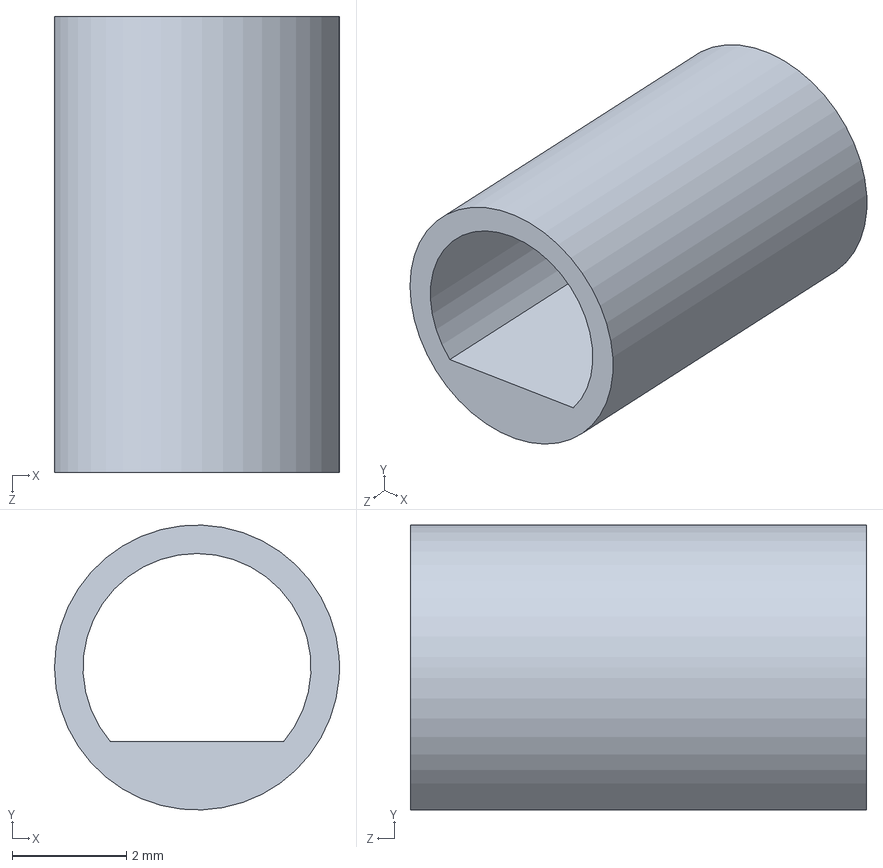
[picture p110: CAD file, 2016-06-03]
Design/Final Assembly/Mil Uydurucu.SLDPRT
5.00 x 5.00 x 8.00 mm
