mettinoktay/Final_Thesis/Design/Final Assembly/RulmanTutucu2.SLDPRT

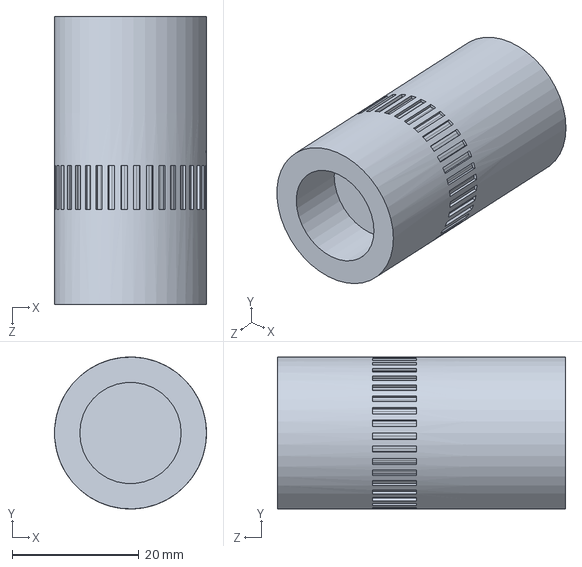
[picture p111: CAD file, 2016-06-03]
Design/Final Assembly/RulmanTutucu2.SLDPRT
24.0 x 24.0 x 45.5 mm
