mettinoktay/Final_Thesis/Design/Final Assembly/Step Dosyaları/Wing Holder.STEP

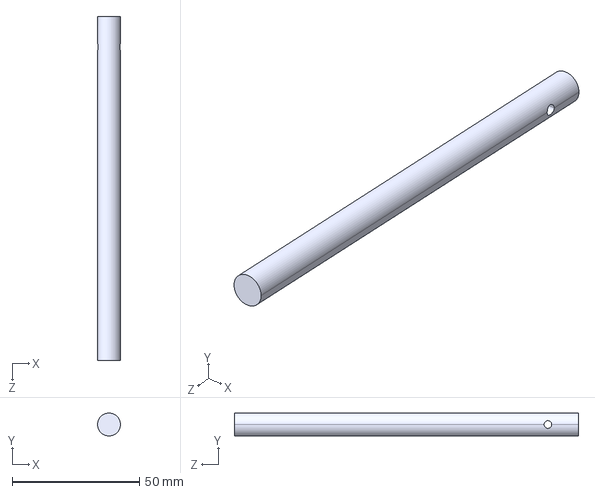
[picture p112: CAD file, 2016-06-03]
Design/Final Assembly/Step Dosyaları/Wing Holder.STEP
9.00 x 9.00 x 135.0 mm
