mettinoktay/Final_Thesis/Design/Final Assembly/Generator Holder.SLDPRT

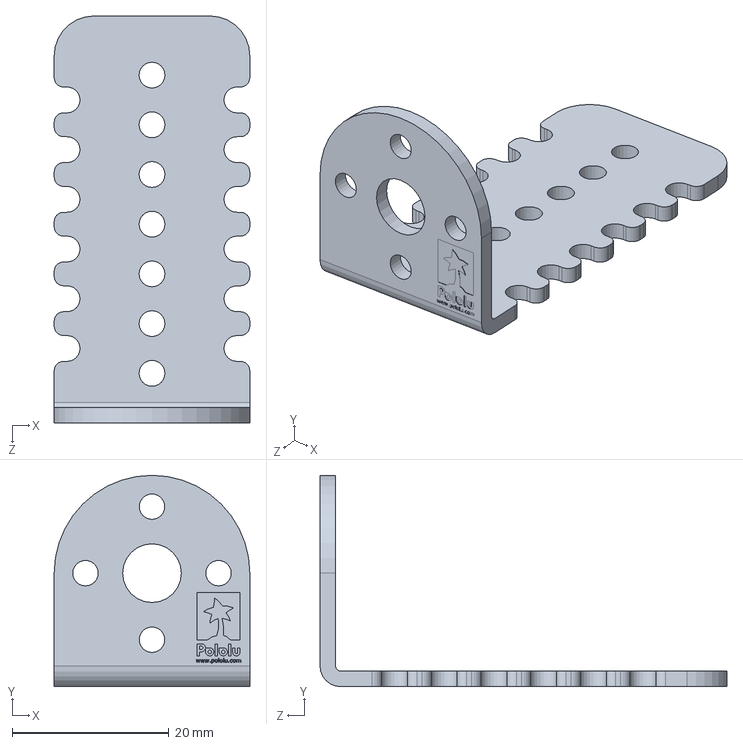
[picture p113: CAD file, 2016-06-03]
Design/Final Assembly/Generator Holder.SLDPRT
25.0 x 27.0 x 52.0 mm
