mettinoktay/Final_Thesis/Design/Final Assembly/Step Dosyaları/HousingUpperPart_Last.STEP

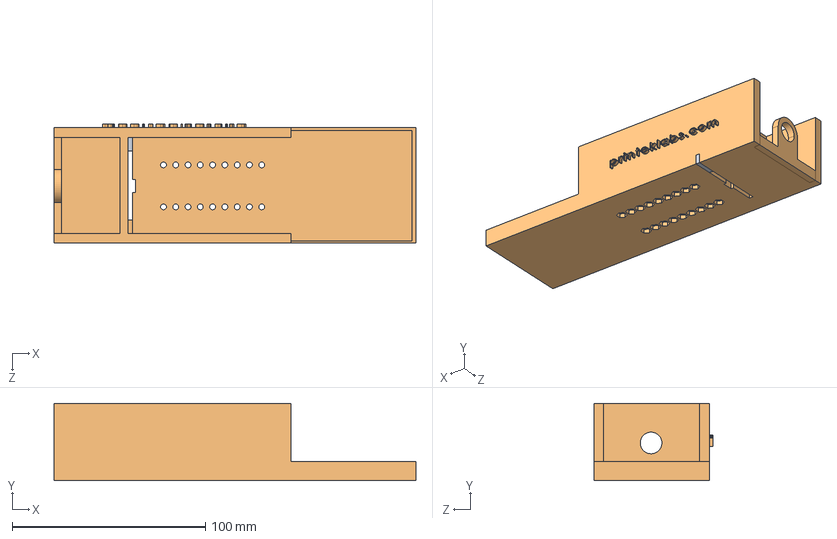
[picture p114: CAD file, 2016-06-03]
Design/Final Assembly/Step Dosyaları/HousingUpperPart_Last.STEP
187.2 x 40.0 x 61.7 mm
