mettinoktay/Final_Thesis/Design/Final Assembly/Step Dosyaları/StepperHolder_Last.STEP

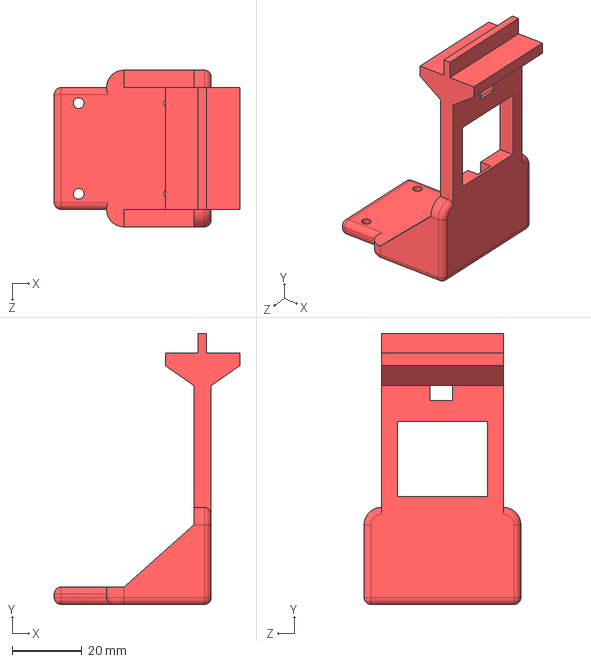
[picture p115: CAD file, 2016-06-03]
Design/Final Assembly/Step Dosyaları/StepperHolder_Last.STEP
53.2 x 77.7 x 44.9 mm
