mettinoktay/Final_Thesis/Design/Final Assembly/Potentiometer.SLDPRT

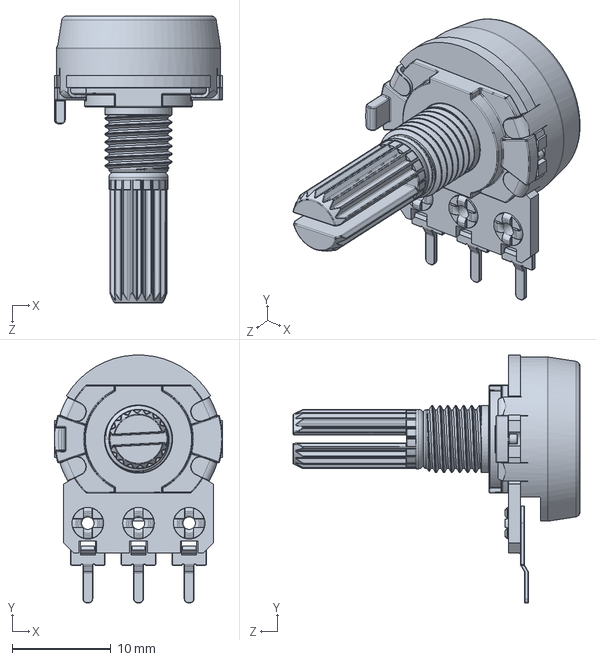
[picture p116: CAD file, 2016-06-03]
Design/Final Assembly/Potentiometer.SLDPRT
17.0 x 25.0 x 29.0 mm
