mettinoktay/Final_Thesis/Design/Final Assembly/Step Dosyaları/Cowling.STEP

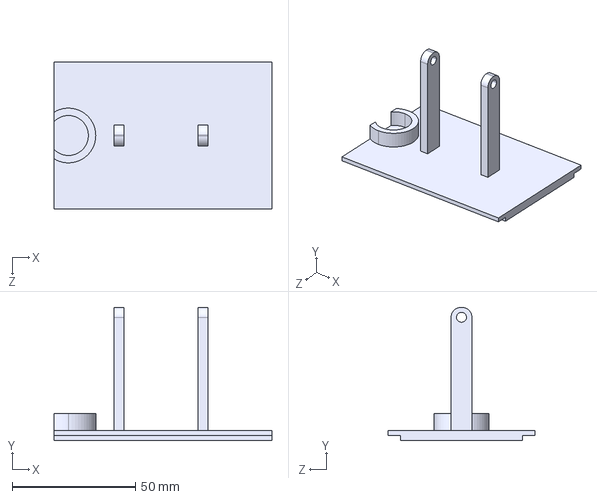
[picture p117: CAD file, 2016-06-03]
Design/Final Assembly/Step Dosyaları/Cowling.STEP
88.4 x 54.0 x 59.7 mm
