mettinoktay/Final_Thesis/Design/Final Assembly/Housing.SLDPRT

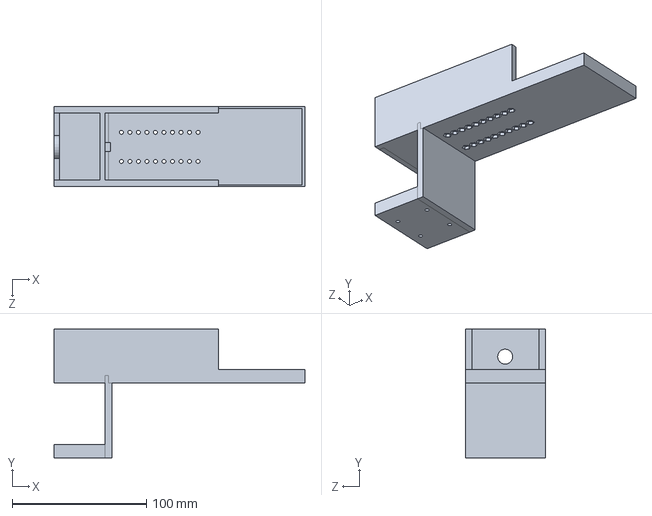
[picture p118: CAD file, 2016-06-03]
Design/Final Assembly/Housing.SLDPRT
187.2 x 96.0 x 59.7 mm
