mettinoktay/Final_Thesis/Design/Final Assembly/Generator.SLDPRT

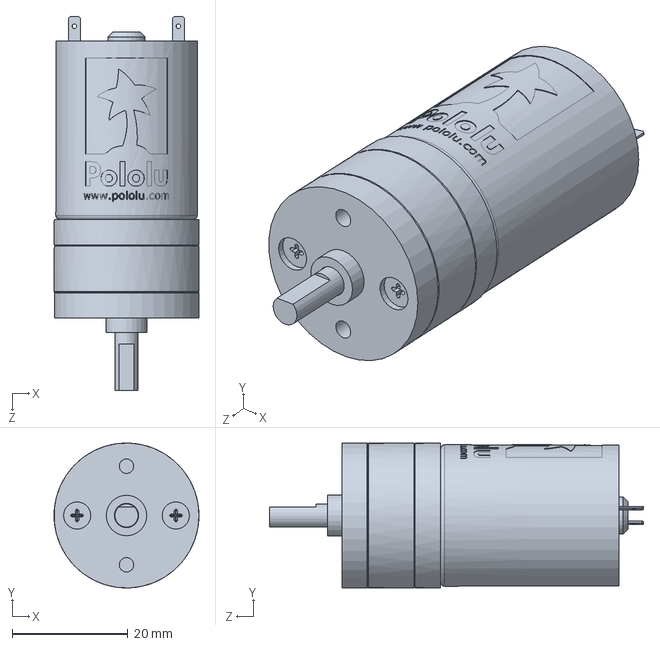
[picture p119: CAD file, 2016-06-03]
Design/Final Assembly/Generator.SLDPRT
25.0 x 25.0 x 64.5 mm
