mettinoktay/Final_Thesis/(list of files, cad)

Other CAD files:
Design/Turbine Design/NACA5518.dwg
Design/Final Assembly/Wind Vane.SLDPRT
Design/Final Assembly/Step Dosyaları/Mil Uydurucu.STEP
Design/Final Assembly/HousingUpperPart_Last.sldprt
Design/Final Assembly/Step Dosyaları/RulmanTutucu2.STEP
Design/Final Assembly/StepperHolder_Last.sldprt
Design/Final Assembly/Cowling.SLDPRT
Design/Final Assembly/Wing Holder.SLDPRT
Design/Final Assembly/Technical Drawings/Turbine.SLDDRW
