mettinoktay/Final_Thesis/Final Report/#5 Teknik Çizimler.PDF

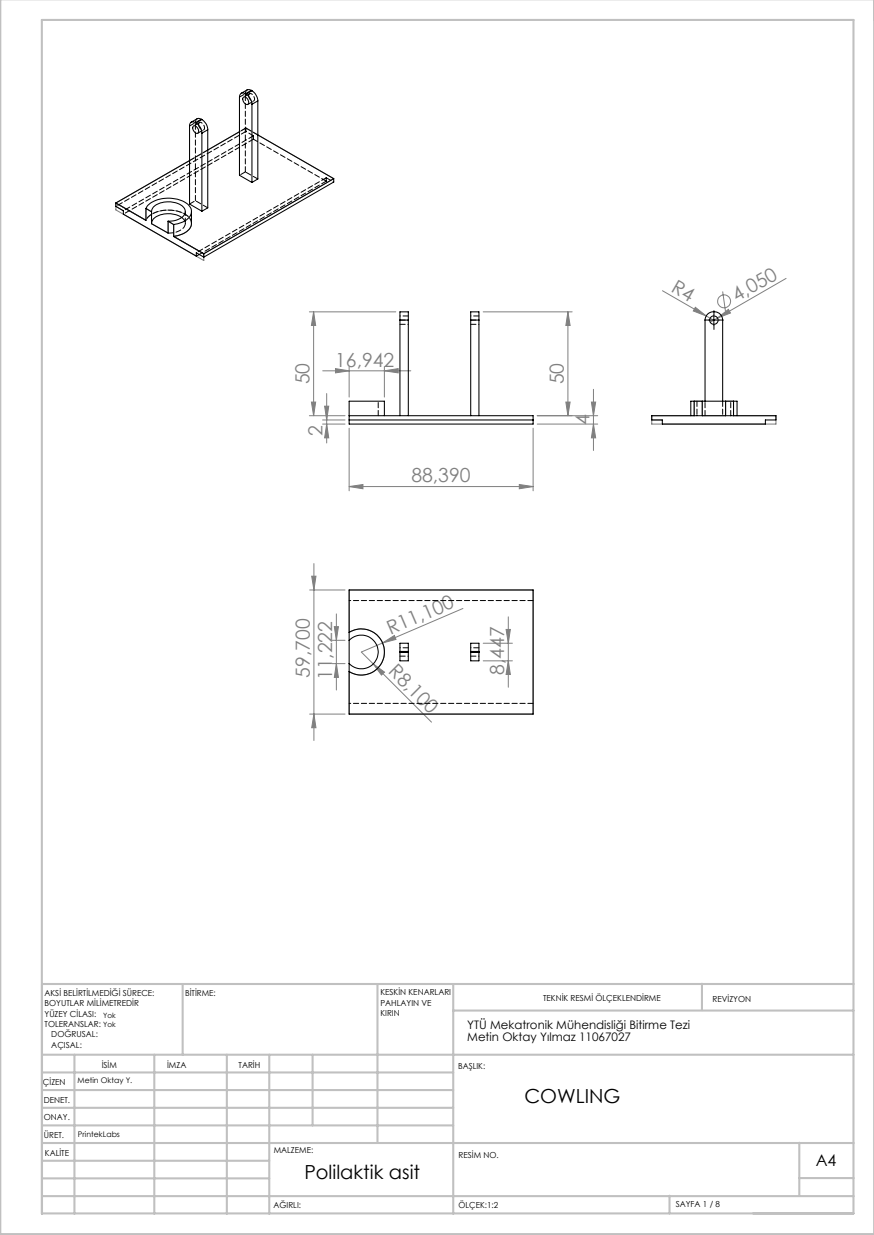
[picture p120: page 1]
Yok; YTÜ Mekatronik Mühendisliği Bitirme Tezi; ÖLÇEK:1:2; SAYFA 1 / 8; TEKNİK RESMİ ÖLÇEKLENDİRME; REVİZYON; KESKİN KENARLARI PAHLAYIN VE; AKSİ BELİRTİLMEDİĞİ SÜRECE:; BİTİRME:; BOYUTLAR MİLİMETREDİR YÜZEY CİLASI:

Metin Oktay Yılmaz 11067027

İSİM | İMZA | TARİH | | | | BAŞLIK: COWLING

ÇİZEN | Metin Oktay Y.
DENET.
ONAY.
ÜRET. | PrintekLabs
KALİTE | | | | MALZEME: Polilaktik asit | RESİM NO. | A4

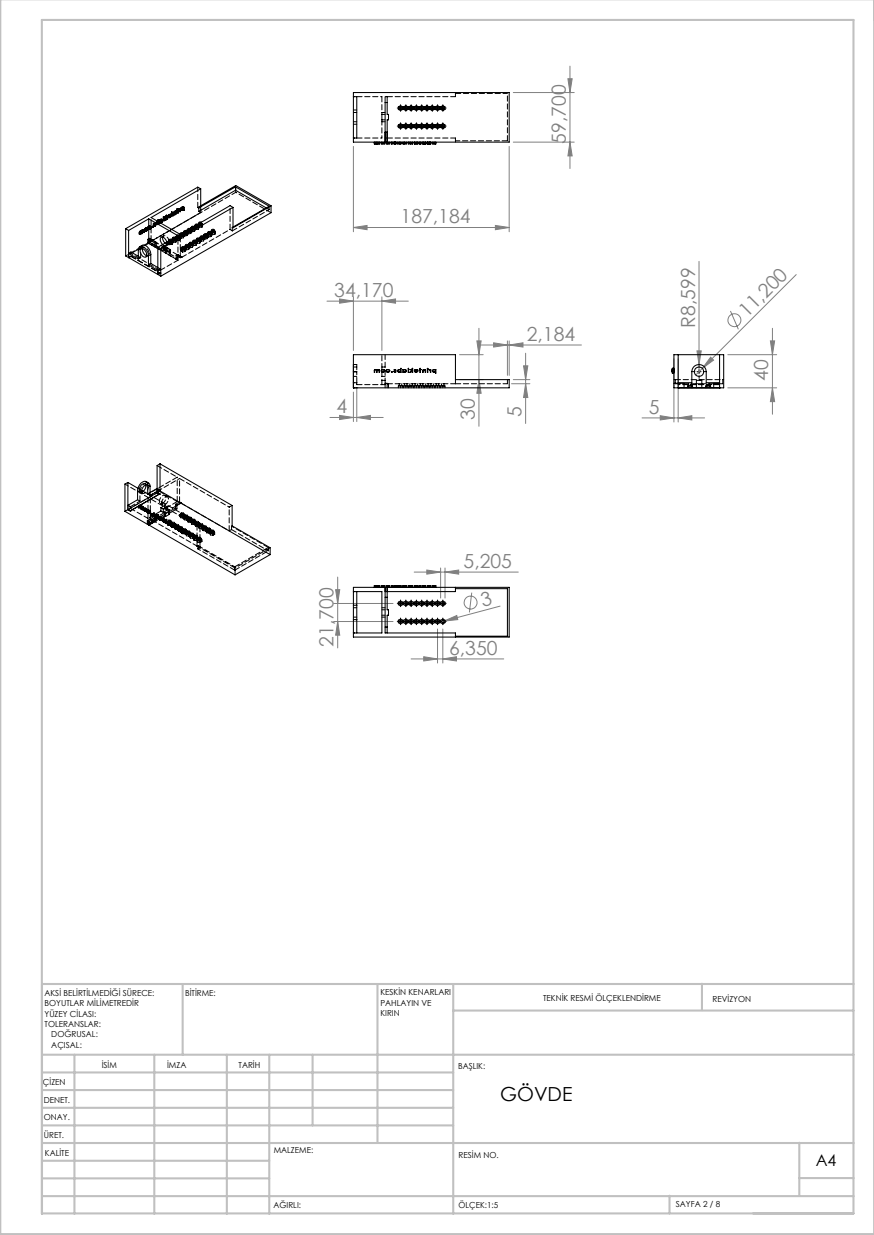
[picture p121: page 2]
ÖLÇEK:1:5; SAYFA 2 / 8; TEKNİK RESMİ ÖLÇEKLENDİRME; REVİZYON; KESKİN KENARLARI PAHLAYIN VE; AKSİ BELİRTİLMEDİĞİ SÜRECE:; BİTİRME:; BOYUTLAR MİLİMETREDİR YÜZEY CİLASI:

İSİM | İMZA | TARİH | BAŞLIK: GÖVDE
ÇİZEN
DENET.
ONAY.

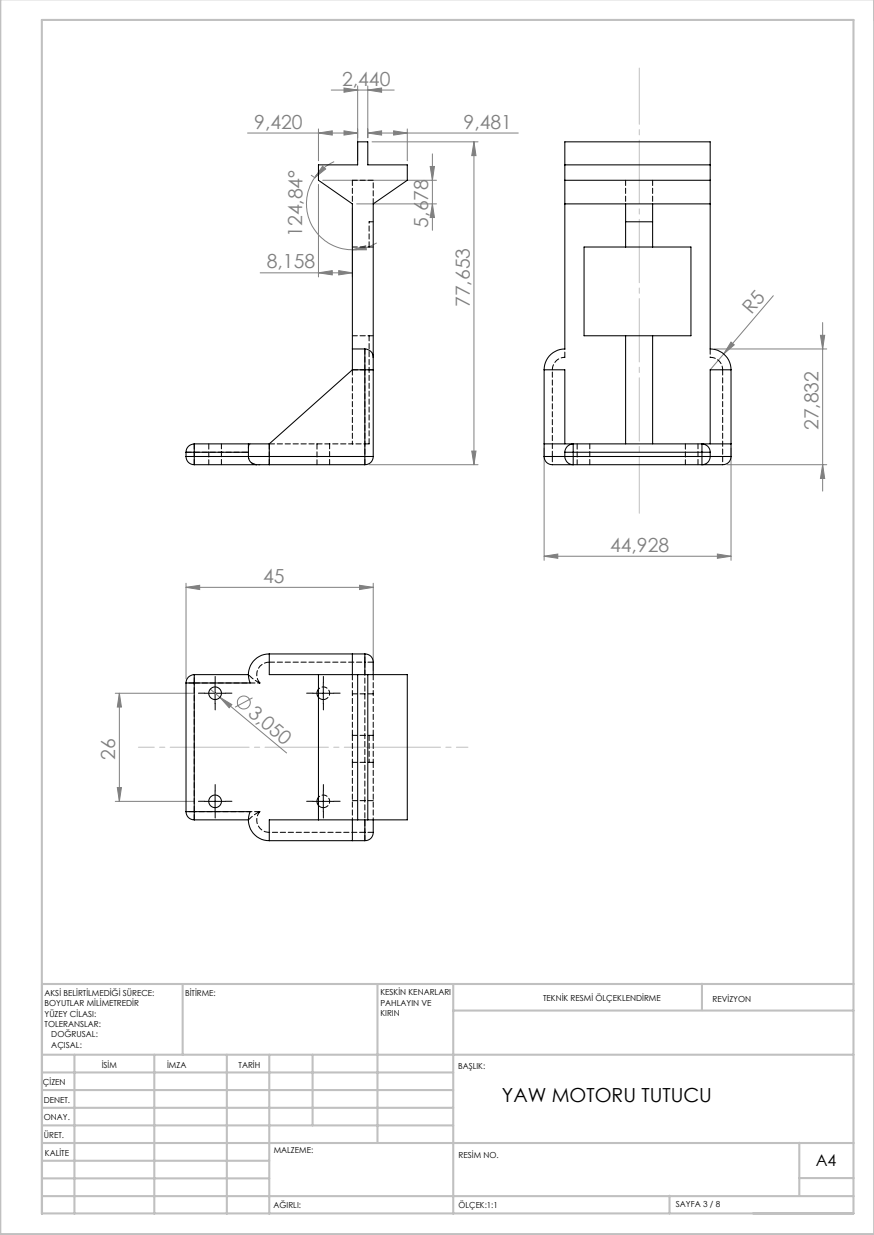
[picture p122: page 3]
ÖLÇEK:1:1; SAYFA 3 / 8; TEKNİK RESMİ ÖLÇEKLENDİRME; REVİZYON; KESKİN KENARLARI PAHLAYIN VE; AKSİ BELİRTİLMEDİĞİ SÜRECE:; BİTİRME:; BOYUTLAR MİLİMETREDİR YÜZEY CİLASI:

İSİM | İMZA | TARİH | BAŞLIK: YAW MOTORU TUTUCU

ÇİZEN
DENET.
ONAY.

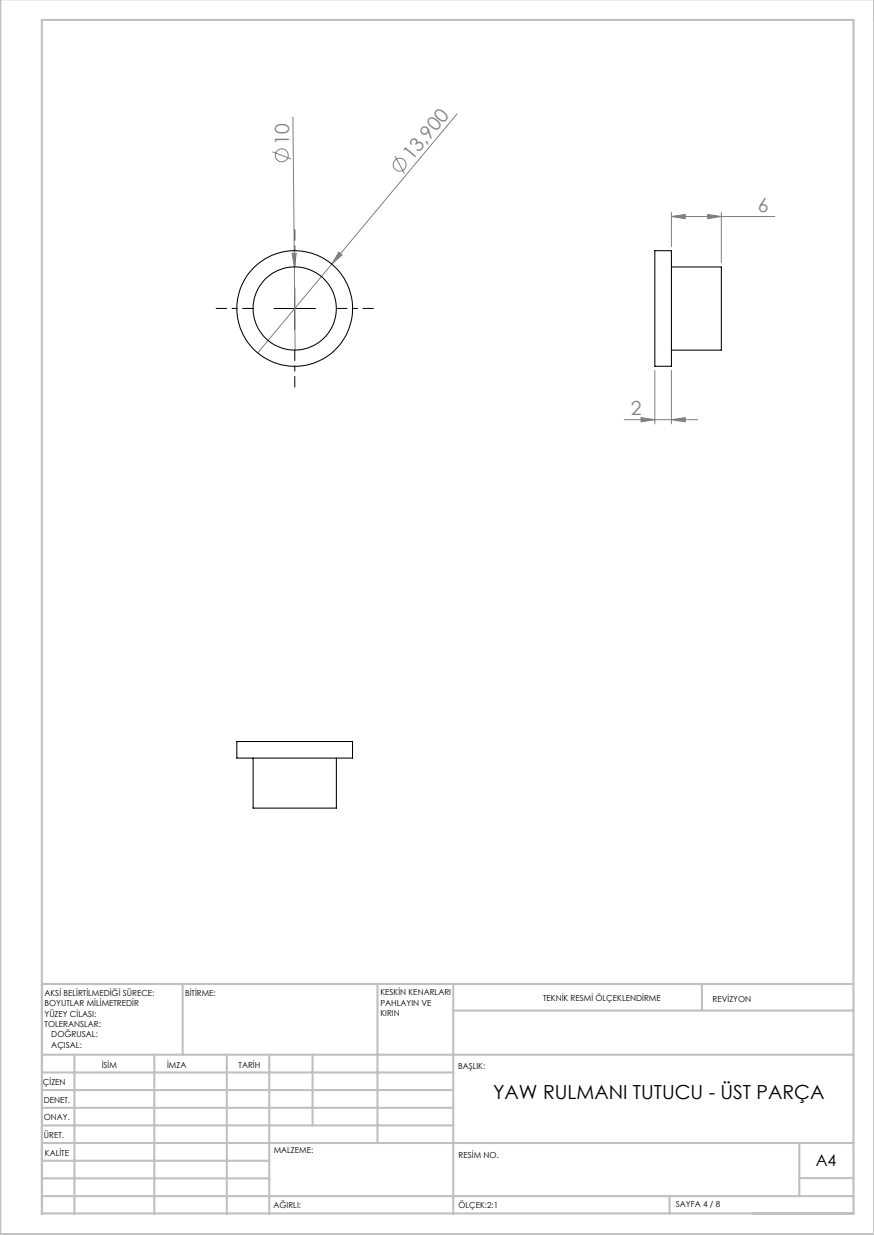
[picture p123: page 4]
ÖLÇEK:2:1; SAYFA 4 / 8; TEKNİK RESMİ ÖLÇEKLENDİRME; REVİZYON; KESKİN KENARLARI PAHLAYIN VE; AKSİ BELİRTİLMEDİĞİ SÜRECE:; BİTİRME:; BOYUTLAR MİLİMETREDİR YÜZEY CİLASI:

İSİM | İMZA | TARİH | BAŞLIK: YAW RULMANI TUTUCU - ÜST PARÇA
ÇİZEN
DENET.
ONAY.

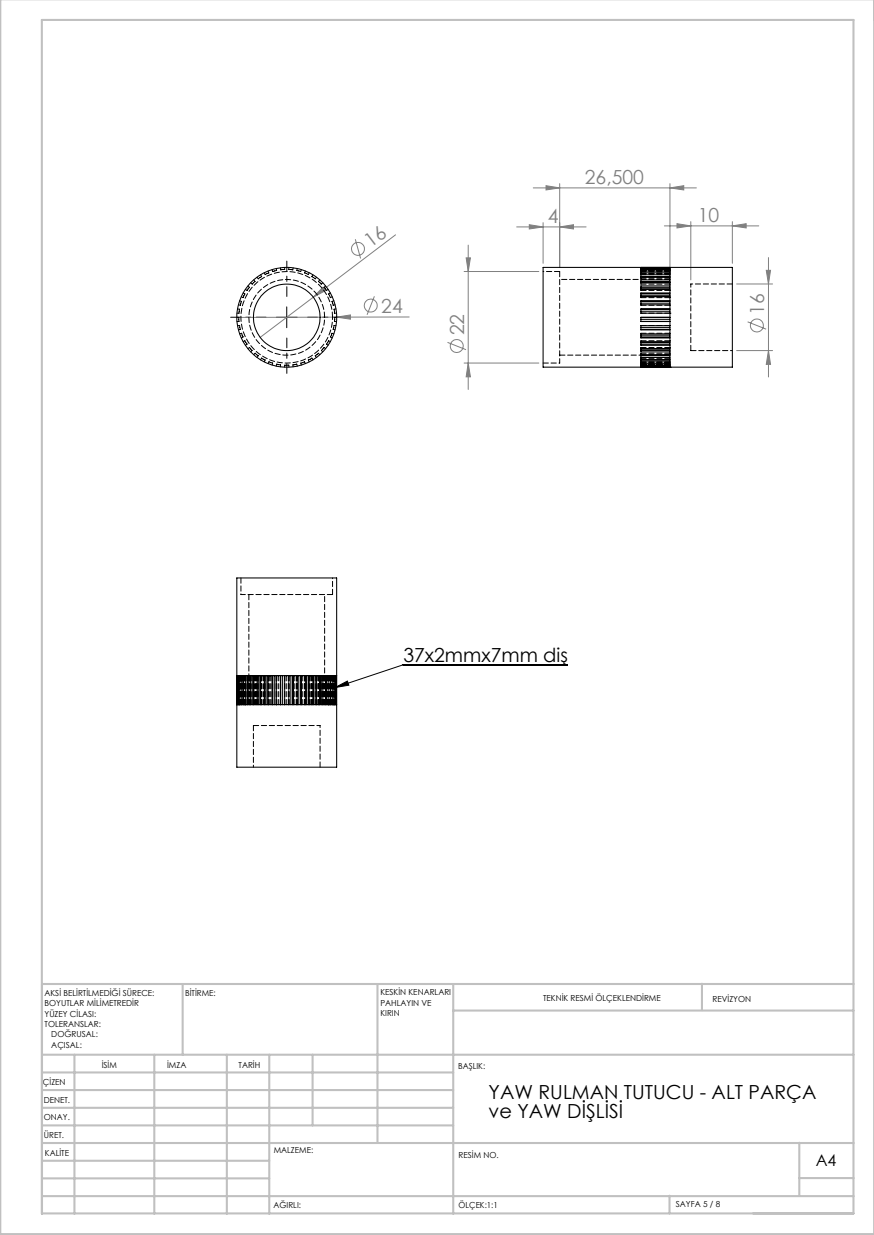
[picture p124: page 5]
37x2mmx7mm diş; ÖLÇEK:1:1; SAYFA 5 / 8; TEKNİK RESMİ ÖLÇEKLENDİRME; REVİZYON; KESKİN KENARLARI PAHLAYIN VE; AKSİ BELİRTİLMEDİĞİ SÜRECE:; BİTİRME:; BOYUTLAR MİLİMETREDİR YÜZEY CİLASI:

İSİM | İMZA | TARİH | BAŞLIK: YAW RULMAN TUTUCU - ALT PARÇA ve YAW DİŞLİSİ
ÇİZEN
DENET.
ONAY.

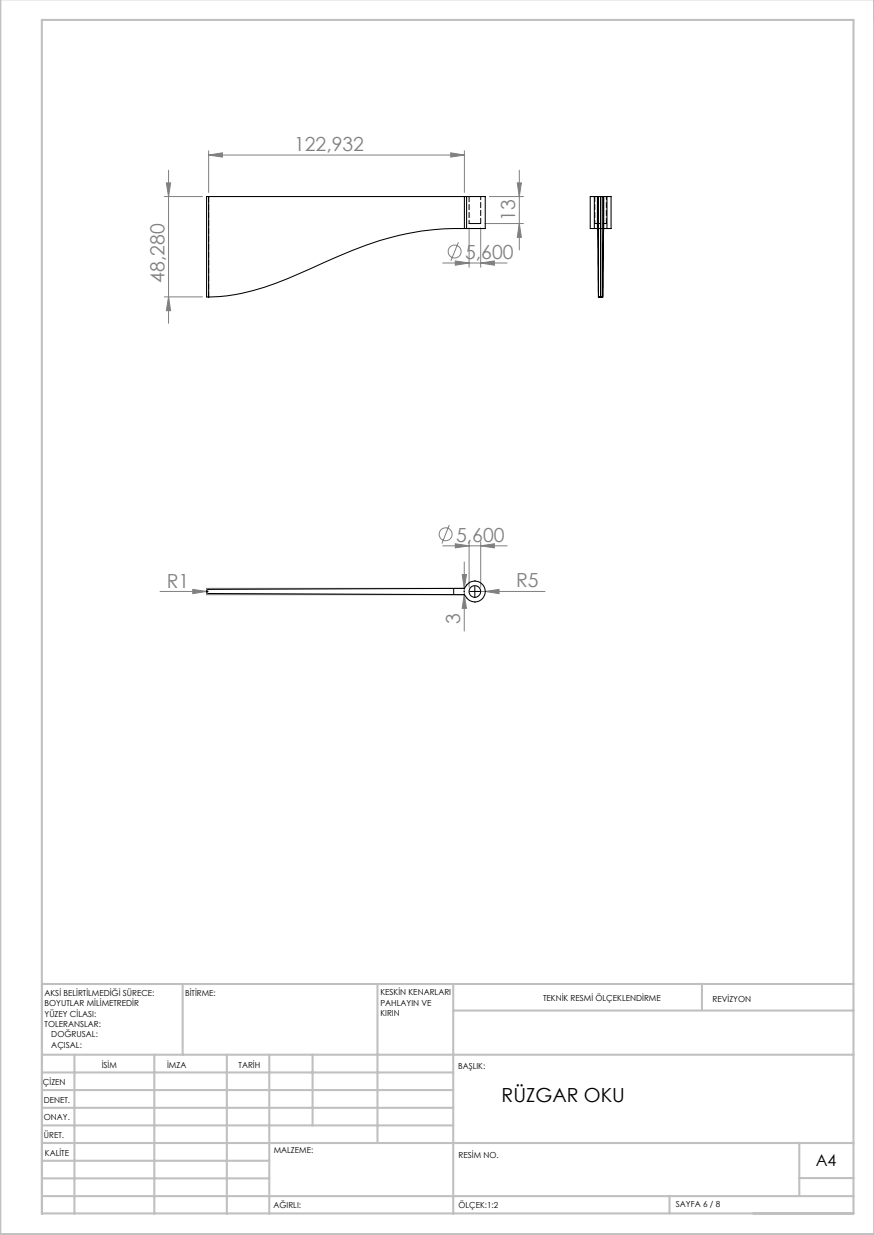
[picture p125: page 6]
ÖLÇEK:1:2; SAYFA 6 / 8; TEKNİK RESMİ ÖLÇEKLENDİRME; REVİZYON; KESKİN KENARLARI PAHLAYIN VE; AKSİ BELİRTİLMEDİĞİ SÜRECE:; BİTİRME:; BOYUTLAR MİLİMETREDİR YÜZEY CİLASI:

İSİM | İMZA | TARİH | BAŞLIK: RÜZGAR OKU
ÇİZEN
DENET.
ONAY.

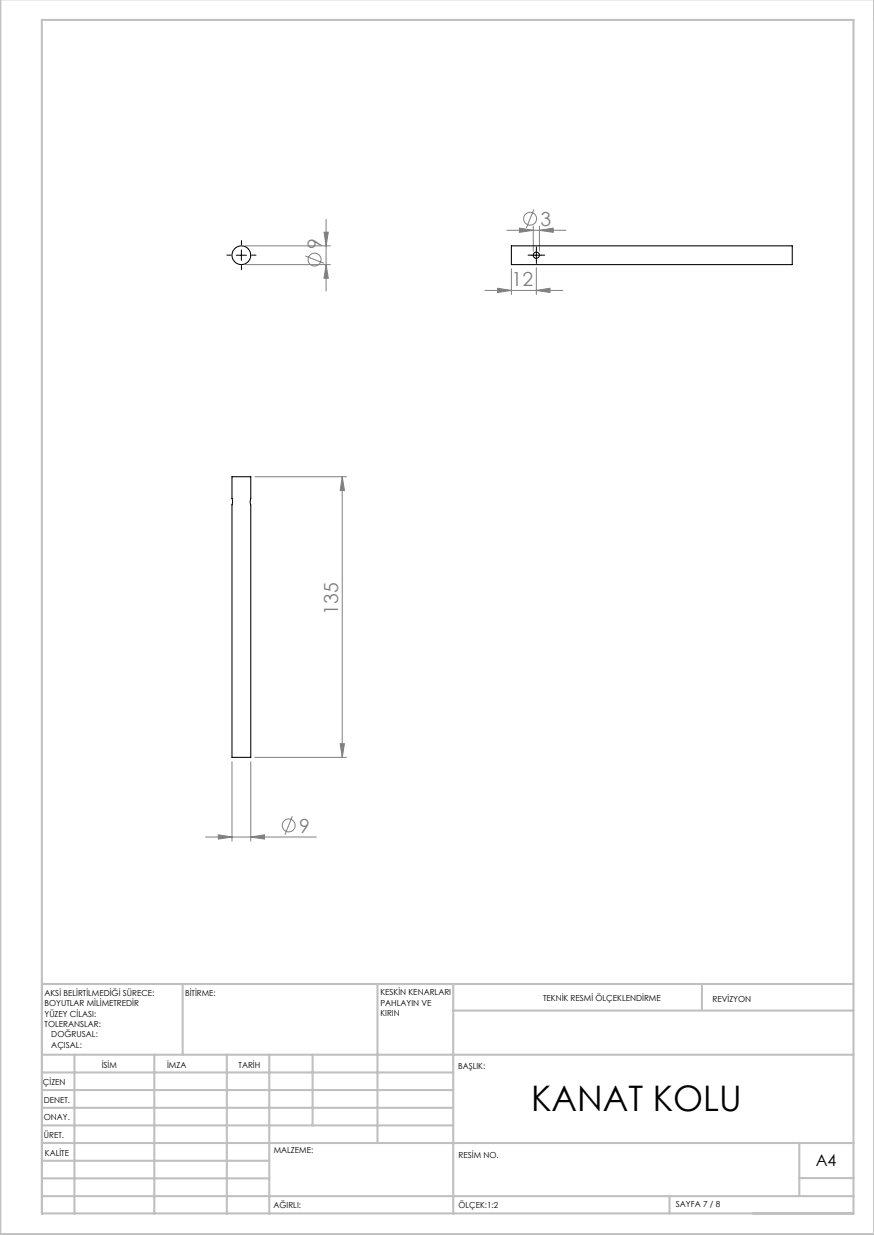
[picture p126: page 7]
ÖLÇEK:1:2; SAYFA 7 / 8; TEKNİK RESMİ ÖLÇEKLENDİRME; REVİZYON; KESKİN KENARLARI PAHLAYIN VE; AKSİ BELİRTİLMEDİĞİ SÜRECE:; BİTİRME:; BOYUTLAR MİLİMETREDİR YÜZEY CİLASI:

İSİM | İMZA | TARİH | BAŞLIK: KANAT KOLU

ÇİZEN
DENET.
ONAY.

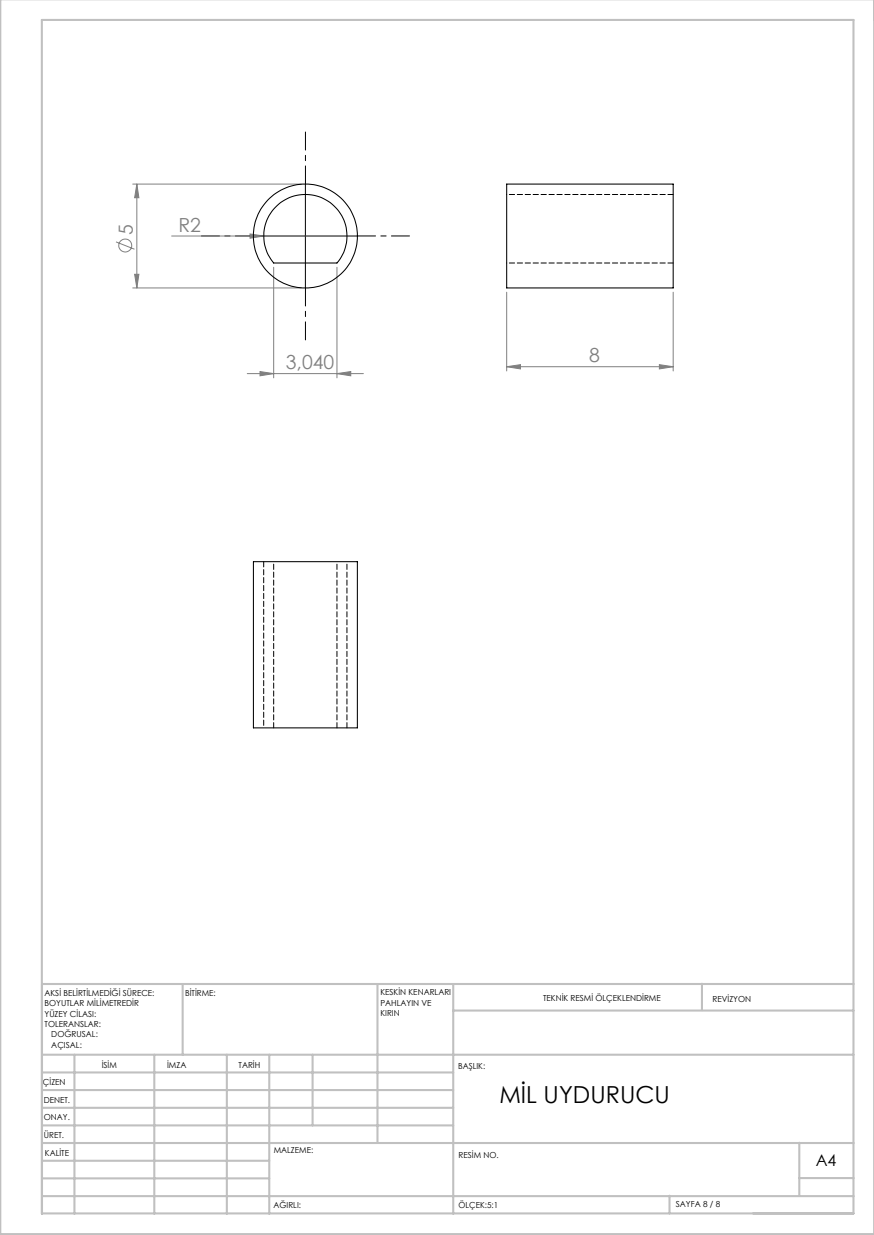
[picture p127: page 8]
ÖLÇEK:5:1; SAYFA 8 / 8; TEKNİK RESMİ ÖLÇEKLENDİRME; REVİZYON; KESKİN KENARLARI PAHLAYIN VE; AKSİ BELİRTİLMEDİĞİ SÜRECE:; BİTİRME:; BOYUTLAR MİLİMETREDİR YÜZEY CİLASI:

İSİM | İMZA | TARİH | BAŞLIK: MİL UYDURUCU
ÇİZEN
DENET.
ONAY.
