mettinoktay/Final_Thesis/Design/PCB Design/Arch Pro - obsolete/arch_pro.brd

## EAGLE design Design/PCB Design/Arch Pro - obsolete/arch_pro.brd (2016-02-01, an earlier design)

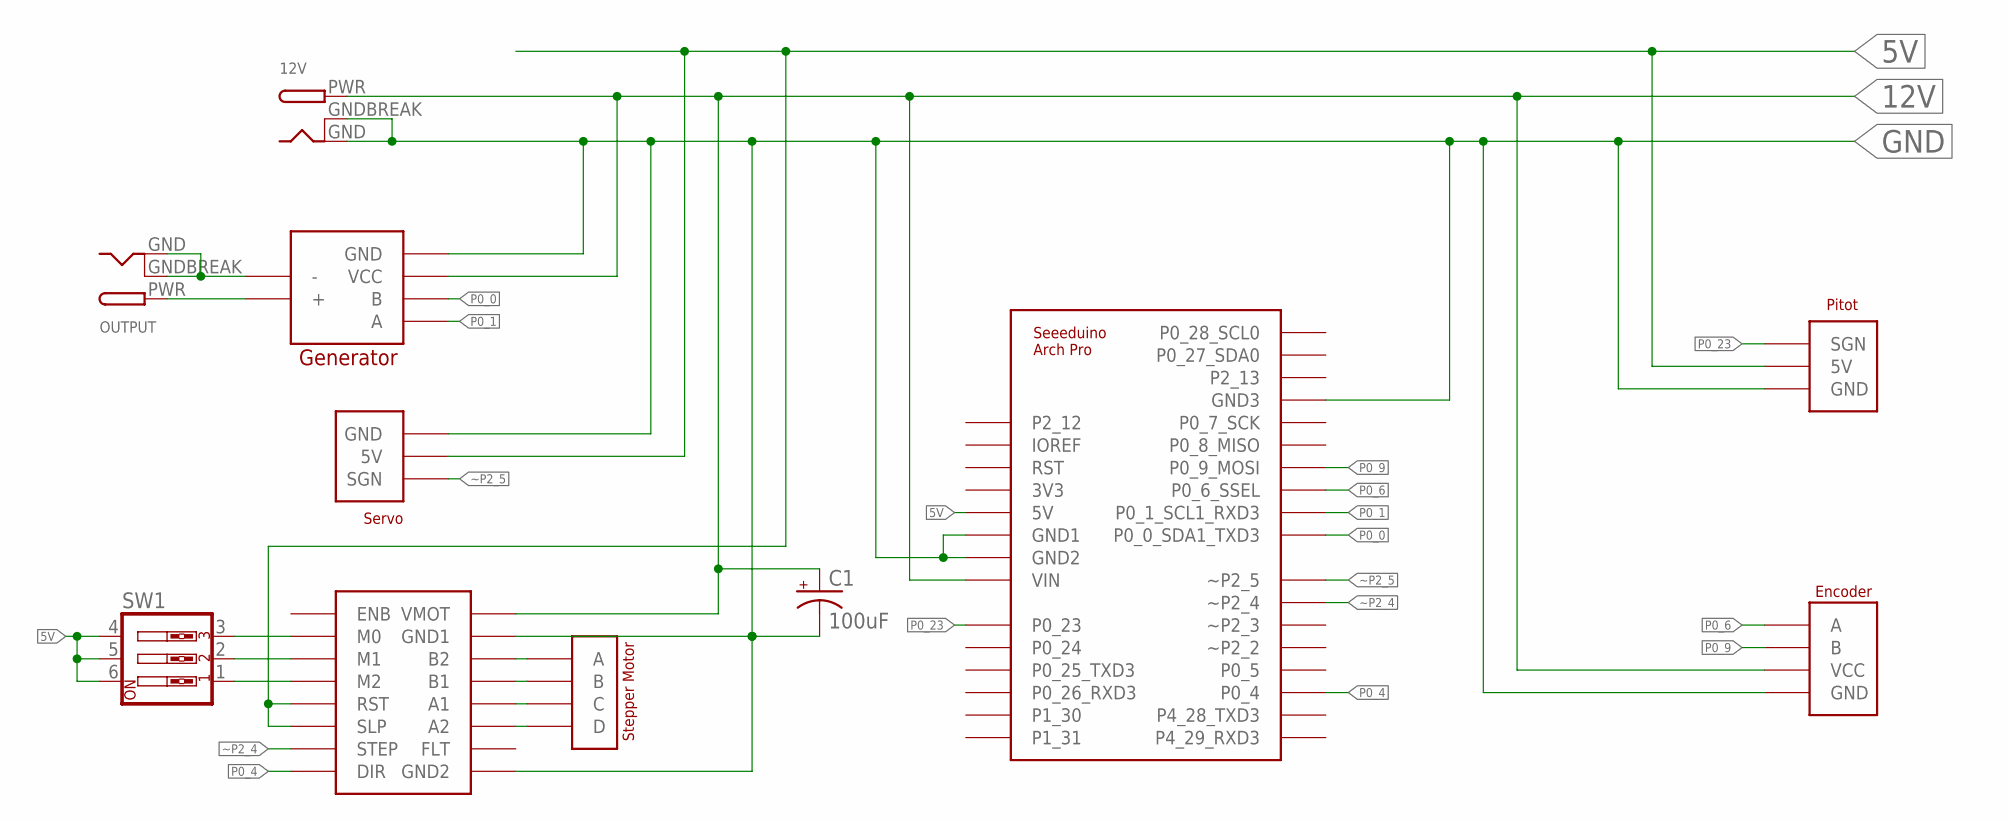
[picture p128: schematic arch_pro.sch]

Parts:
12V: DCBARRELPTH; DCJACK_2MM_PTH
C1: 100uF; CPOL-RADIAL-100UF-25V
OUTPUT: DCBARRELPTH; DCJACK_2MM_PTH
SAP1: ARCH_PROSHIELD; ARCH_PRO
SW1: SW_DIP-3; EDG-03
U$1: ENCODER
U$2: GENERATOR
U$3: PITOT
U$4: SERVO
U$5: STEPPER
U$6: STEPPER_DRIVER

Connections:
5V: SAP1.5V, SW1.4, SW1.5, SW1.6, U$3.5V, U$4.5V, U$6.RST, U$6.SLP
12V: 12V.PWR, C1.1 (+), SAP1.VIN, U$1.VCC, U$2.VCC, U$6.VMOT
GND: 12V.GND, 12V.GNDBREAK, C1.2 (-), SAP1.GND1, SAP1.GND2, SAP1.GND3, U$1.GND, U$2.GND, U$3.GND, U$4.GND, U$6.GND (GND1), U$6.GND1 (GND2)
unnamed: U$5.A, U$6.B2
unnamed: U$5.B, U$6.B1
unnamed: U$5.C, U$6.A1
unnamed: U$5.D, U$6.A2
unnamed: OUTPUT.PWR, U$2.+
unnamed: SW1.3, U$6.M0
unnamed: SW1.2, U$6.M1
unnamed: SW1.1, U$6.M2
unnamed: OUTPUT.GND, OUTPUT.GNDBREAK, U$2.-
P0_0: SAP1.P0_0_SDA1_TXD3, U$2.B
P0_1: SAP1.P0_1_SCL1_RXD3, U$2.A
P0_4: SAP1.P0_4, U$6.DIR
P0_6: SAP1.P0_6_SSEL, U$1.A
P0_9: SAP1.P0_9_MOSI, U$1.B
P0_23: SAP1.P0_23, U$3.SGN
~P2_4: SAP1.~P2_4, U$6.STEP
~P2_5: SAP1.~P2_5, U$4.SGN

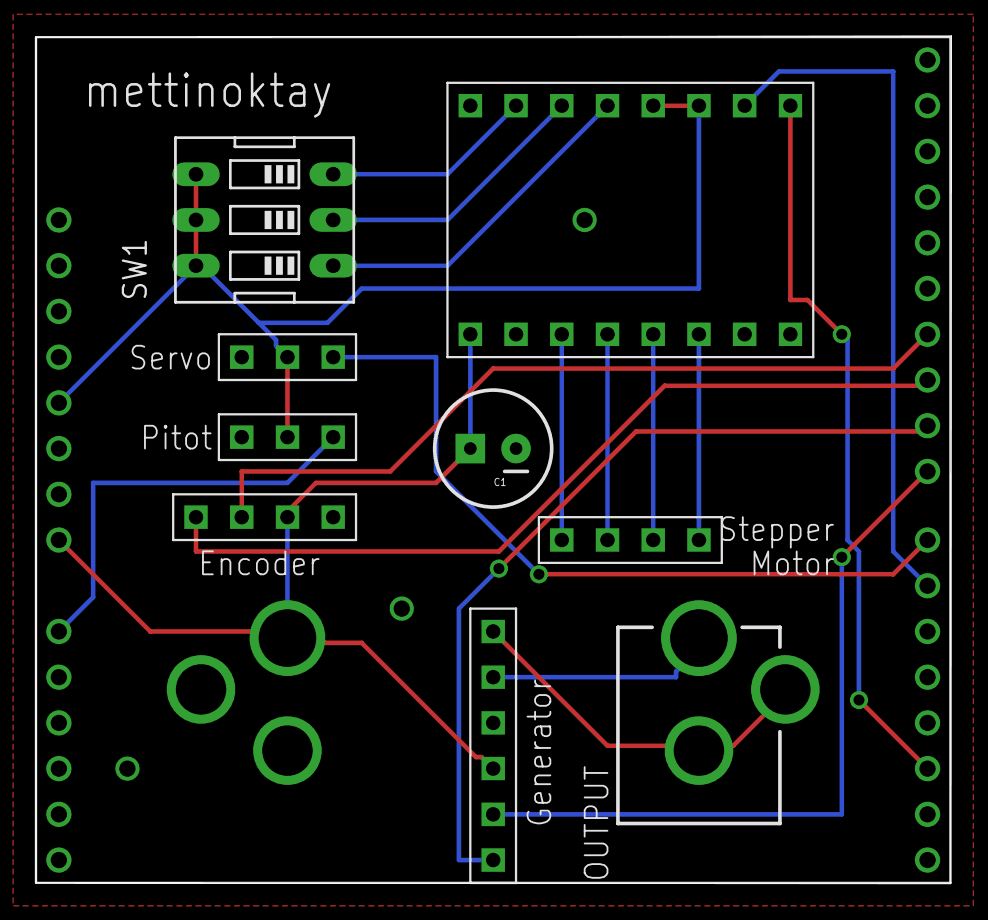
[picture p129: board arch_pro.brd from above]

Board: 2 copper layers, 50.9 x 47.1 mm, 11 parts (1 on the bottom side), 20 nets.
