mettinoktay/Final_Thesis/Design/PCB Design/Arduino Nano -active/nano.brd

## EAGLE design Design/PCB Design/Arduino Nano -active/nano.brd (2016-03-06)

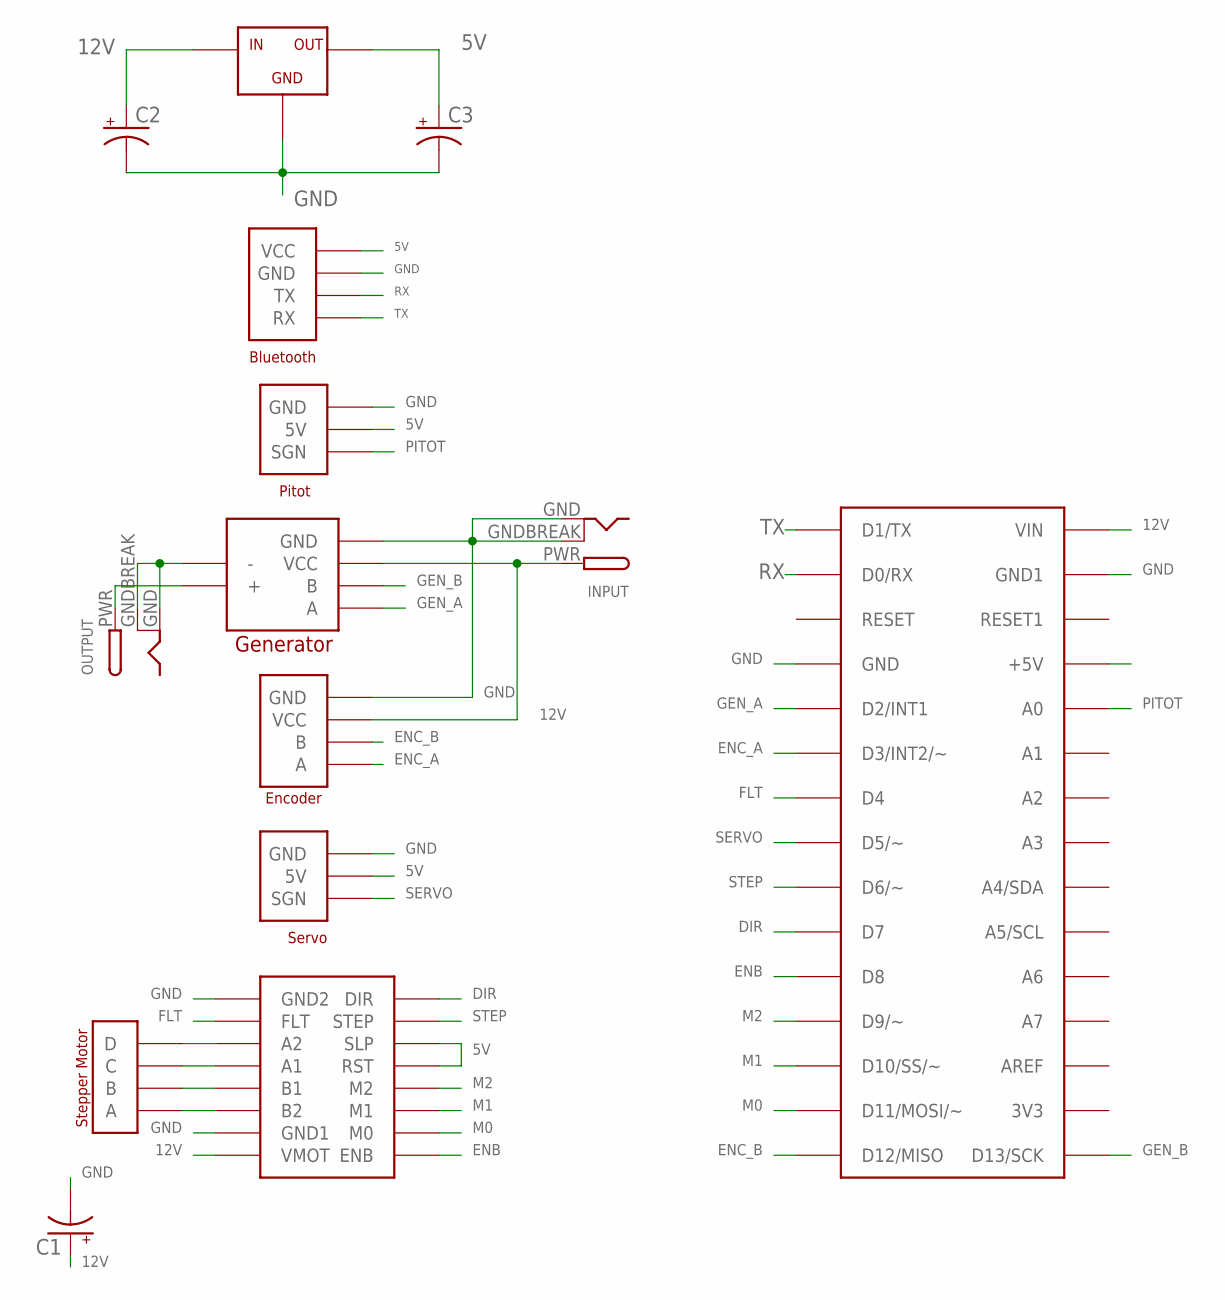
[picture p130: schematic nano.sch]

Parts:
C1, C2, C3: 100UF-25V-20%(PTH); CPOL-RADIAL-100UF-25V
INPUT: DCBARRELPTH; DCJACK_2MM_PTH
NANO: ARDUINONANO; PDIP-32
OUTPUT: DCBARRELPTH; DCJACK_2MM_PTH
U$1: HC06
U$2: ENCODER
U$3: PITOT
U$4: STEPPER
U$5: STEPPER_DRIVER
U$6: SERVO
U$7: GENERATOR
U$8: 7805

Connections:
5V: C3.1 (+), NANO.+5V, U$1.VCC, U$3.5V, U$5.RST, U$5.SLP, U$6.5V, U$8.OUT
12V: C1.1 (+), C2.1 (+), INPUT.PWR, NANO.VIN, U$2.VCC, U$5.VMOT, U$7.VCC, U$8.IN
DIR: NANO.D7, U$5.DIR
ENB: NANO.D8, U$5.ENB
ENC_A: NANO.D3 (D3/INT2/~), U$2.A
ENC_B: NANO.D12 (D12/MISO), U$2.B
FLT: NANO.D4, U$5.FLT
GEN_A: NANO.D2 (D2/INT1), U$7.A
GEN_B: NANO.D13 (D13/SCK), U$7.B
GND: C1.2 (-), C2.2 (-), C3.2 (-), INPUT.GND, INPUT.GNDBREAK, NANO.GND, NANO.GND1, OUTPUT.GND, OUTPUT.GNDBREAK, U$1.GND, U$2.GND, U$3.GND, U$5.GND (GND1), U$5.GND1 (GND2), U$6.GND, U$7.-, U$7.GND, U$8.GND
M0: NANO.D11 (D11/MOSI/~), U$5.M0
M1: NANO.D10 (D10/SS/~), U$5.M1
M2: NANO.D9 (D9/~), U$5.M2
unnamed: U$4.D, U$5.A2
unnamed: U$4.C, U$5.A1
unnamed: U$4.B, U$5.B1
unnamed: U$4.A, U$5.B2
unnamed: OUTPUT.PWR, U$7.+
PITOT: NANO.A0, U$3.SGN
RX: NANO.D0/RX, U$1.TX
SERVO: NANO.D5 (D5/~), U$6.SGN
STEP: NANO.D6 (D6/~), U$5.STEP
TX: NANO.D1/TX, U$1.RX

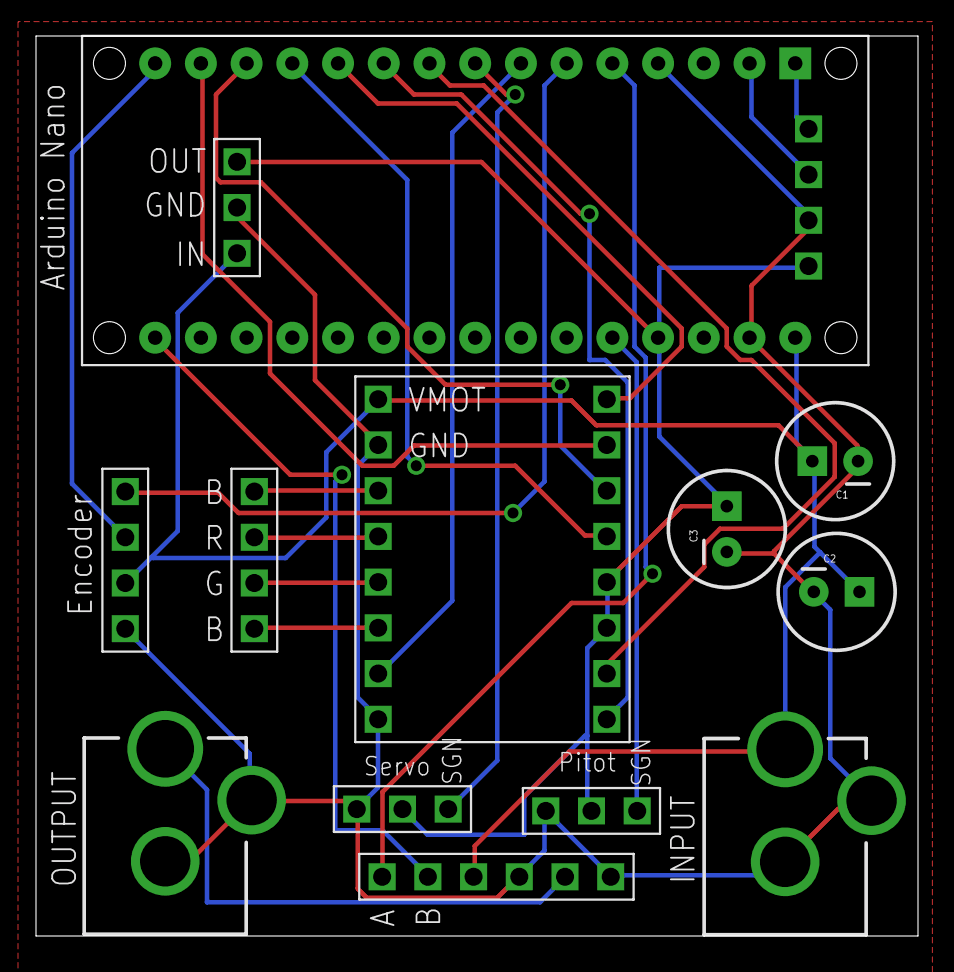
[picture p131: board nano.brd from above]

Board: 2 copper layers, 49.0 x 50.0 mm, 14 parts (1 on the bottom side), 23 nets.
