mettinoktay/Final_Thesis/Design/Code/configuration.h

#ifndef CONFIGURATION_H
#define CONFIGURATION_H

#pragma once

#define CCW      0
#define CW       1

#define FULL     0
#define HALF     8
#define QUARTER  4
#define ONE8TH   12
#define ONE16TH  2
#define ONE32ND  14

#define PITCONV  0.00488758553
#define VANCONV  0.3519
#define AIRDENS  1.225
#define NO_LIFT  45
#define MAX_LIFT 60

//#define BAUD     9600

#endif
