mettinoktay/Final_Thesis/(commit log)

2016-02-01 Added design files and reports
    Final report, PCB files and blade design .m file has been uploaded.
    [Final Thesis.brd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]
2016-02-01 Added EAGLE Files
    EAGLE files of custom shield for controller
    [Final Thesis.brd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]
2016-03-05 First Version
    [Final Thesis.brd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]
2016-03-05 Translated names
    Folder and file names translated to English
    [Final Thesis.brd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]
2016-03-06 Deleted unnecessary files, added EAGLE files of new design
    [arch_pro.brd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]
2016-03-24 Switched to PlatformIO
2016-06-03 Too many changes
    Made too many changes to remember.
    [Cowling.SLDPRT, Cowling.STEP, Generator Holder.SLDPRT, Generator and Holder ASM.SLDASM, Generator.SLDPRT, Housing.SLDPRT, HousingUpperPart_Last.STEP, HousingUpperPart_Last.sldprt]
2016-07-19 Changed library directories
    [RulmanTutucu.SLDPRT, configuration.h, nano.sch]
